creagic11/SNN_BTP/paper/hush_paperA.tex

% Paper A draft (A8.2), started 10 Nov 2026. IEEE two-column conference format (fits TCAS-II brief after cuts, or FCCM).
% Every number is traced to a file in results/ (see notes/paper_outline.md). \pend{...} marks items still to confirm.
% Revised 11 Nov 2026 after an external review (scope of the safety claim, full-width proof, resource accounting,
% heuristic comparison with charged reads, energy and real-time wording, architecture figure, reproducibility).
% Revised again 11 Nov 2026 after a second fresh-eyes review (epoch counts, drift metric, scope of the proof,
% real-time energy at a common speed, references, figures).
\documentclass[conference]{IEEEtran}
\usepackage{amsmath,amssymb,amsthm}
\usepackage{booktabs}
\usepackage{graphicx}
\usepackage{xcolor}
\usepackage{cite}
\usepackage{siunitx}
\usepackage{tikz}
\usepackage{url}
\usetikzlibrary{arrows.meta,positioning,fit,calc}
\newcommand{\pend}[1]{\textcolor{red}{[#1]}}
\newtheorem{theorem}{Theorem}
\newtheorem{corollary}{Corollary}

\begin{document}

\title{HUSH: Provably Safe Sub-Block Hibernation for\\Real-Time Event-Driven SNN Inference on FPGAs}
\author{\IEEEauthorblockN{Anubhav Jha and Rajat Subhra Chakraborty}
\IEEEauthorblockA{Indian Institute of Technology Kharagpur, India}}
\maketitle

\begin{abstract}
In a fully connected spiking layer, most of the time and energy goes into fetching the weights of every neuron for
every input spike, although few neurons fire. We present HUSH, an output-side skipping scheme that puts a sub-block
of eight neurons to sleep for a timestep only when a cheap integer envelope proves that none of them can reach the
threshold. At every timestep the gated layer therefore emits exactly the spikes that the ungated update from its
current state would emit; only the state of sleeping neurons evolves approximately. The envelope combines the exact
maximum membrane potential of the sub-block with a per-input proxy table and is computed while the previous timestep
is processed; its envelope and lane arithmetic is verified formally at the implementation's bit widths. Trained with the gate in the loop, a 578-256-10 integer network on N-MNIST
runs on a Xilinx Artix-7 XC7A100T at 100\,MHz entirely on chip, from raw sensor events to the class: at 95.74\,\%
accuracy it is 2.44$\times$ faster than the same hardware with the gate off (115\,\textmu s vs.\ 280\,\textmu s per
inference; 98.21\,\% accuracy) with 57\,\% less active energy per inference (18.4 vs.\ 42.5\,\textmu J,
estimated from gate-level switching activity), and at 96.54\,\% 1.75$\times$ faster with 44\,\% less; the gate
costs 79\,\% more LUTs and 19\,\% more block RAM. On the same chip, with BASE's
10-epoch weights, the open Spiker+ generator needs 818\,\textmu s and 255\,\textmu J (6.0$\times$ BASE). In cycle-accurate RTL replay of
four N-MNIST recordings at their recorded timing, every 3\,ms window is processed within 4.5\,\textmu s of its end,
and the design sustains up to 1.33--2$\times$ the event rate of the ungated design with the same 1,024-event input
buffer.
\end{abstract}

\section{Introduction}
Event-driven spiking neural networks (SNNs) are attractive for always-on sensing because their input is sparse
and their arithmetic is additive. On FPGAs, accelerators usually exploit \emph{input} sparsity: work is done only
for input spikes that occur. For a fully connected layer with $N$ neurons, each input spike still costs $N$ weight
reads from block RAM, although in a given timestep only a few percent of the neurons fire. Skipping the
\emph{output} side, i.e.\ neurons that will not fire, is the remaining large saving, but it is hard: whether a
neuron fires depends on the very weights one wants to skip. The output-side schemes published for SNNs are, to our
knowledge, heuristics (they predict that a neuron stays silent and can be wrong) and therefore change the network's
behaviour in ways that are hard to bound.

We make output-side skipping \emph{provably safe}. Our contributions:
\begin{enumerate}
\item \textbf{HUSH gate:} an integer envelope per sub-block of eight neurons that upper-bounds every member's next
membrane potential from the sub-block's exact current maximum and a per-input proxy table; a sub-block sleeps only
if the bound is below threshold (Theorem~1), so at every timestep the gated layer emits exactly the spikes of the
ungated update from its current state. We separate this per-timestep guarantee from end-to-end equivalence, which it
does not give, and measure the difference. The RTL envelope and lane arithmetic is proved, at its real bit widths
and for all values, to keep the bound, given that each neuron's drive is at most the proxy drive $D_c$ (true by
construction of the proxy table).
\item \textbf{Architecture:} an envelope unit overlapped with the processing of the previous timestep, per-sub-block
weight-column RAM enables, a whole network on chip (hidden layer, output layer overlapped one timestep behind, and an
integer class decision), and a stream front-end that accepts raw DVS events.
\item \textbf{Evaluation on one chip:} bit- and cycle-exact RTL against a golden model; gate-level activity-based
power; the same RTL with the gate off as baseline (BASE); Spiker+~\cite{spikerplus} on the same device with BASE's weights;
three training seeds per point; and real-time operation on N-MNIST event streams replayed at sensor timing.
\end{enumerate}

\section{Background and related work}\label{sec:bg}
\textbf{Integer LIF.} Each neuron keeps a 16-bit saturating potential $V$. Per timestep $t$,
$U = \mathrm{sat}(L(V) + \sum_{j\in A_t} w_{j})$ with leak $L(V)=V-(V\gg k)$, $k=4$, INT8 weights and $A_t$ the
active inputs; the sum is exact before the single saturation. It spikes, $s=[U\ge\theta]$ ($\theta=64$), and keeps
$V' = U-\theta s$ (soft reset).

\textbf{FPGA SNN accelerators.} Spiker~\cite{spiker}, its generator Spiker+~\cite{spikerplus} and
FireFly~\cite{firefly} are clock-driven: every neuron is updated every timestep. Table~\ref{tab:sota} lists the designs we found that report N-MNIST
results on an FPGA. They differ in network, device and power method; for two we found no latency.

\textbf{Output-side skipping.} Three recent designs skip work for neurons predicted not to fire:
Early~\cite{early} stops accumulation for neurons whose partial sum of the largest weights stays below a tuned
threshold; SITRA~\cite{sitra} scores each output of a spiking transformer with a weight-MSB dot product and skips the
weight fetches of outputs it predicts silent, overlapping detection with the previous token; PS4~\cite{ps4}
speculates whether each neuron fires within a time window and recomputes the window step by step when a speculation
fails. Early and SITRA accept mispredictions: Early reports a 0.54\,\% mean accuracy loss over its benchmarks and
SITRA 1--2\,\%; PS4 trades mispredictions for recomputation time instead. All three use tuned thresholds or
speculation and are evaluated with architecture simulators and ASIC synthesis (28 or 65\,nm), not on an FPGA. SPARSH~\cite{sparsh}
skips zero weights, zero spikes and refractory neurons; C-STEP~\cite{cstep} and the early-stop of~\cite{cheng2025}
end inference early in time. For ReLU CNNs, SnaPEA~\cite{snapea} has an exact mode: with non-negative inputs and
weights sorted by sign, a convolution stops once its partial sum turns negative. It still reads weights up to that
point, per neuron, and has no state across time. HUSH differs in that its prediction is a proven bound that is
evaluated before any weight of the sub-block is read: a sleeping sub-block cannot
contain a neuron that would fire at that timestep, the bound carries membrane state across timesteps, and its
granularity matches a block-RAM column, so a skip removes whole memory reads on an FPGA.

\section{The HUSH gate}
Neurons are grouped into sub-blocks $c$ of $b=8$ (eight INT8 weights fill one 64-bit block-RAM word; other sizes
were not explored). Two tables are derived offline from the weights: the proxy
$P_{jc}=\max_{i\in c} W_{ji}$ and the mean $Q_{jc}=\lfloor \mathrm{mean}_{i\in c} W_{ji}\rfloor$. The hardware keeps
$R_c=\max_{i\in c} V_i$ exactly after every timestep. Before the weights of timestep $t$ are fetched, the envelope
unit accumulates $D_c=\sum_{j\in A_t} P_{jc}$ and evaluates
\begin{equation}
E_c=\mathrm{sat}\big(L(R_c)+\max(0,D_c)\big),\qquad g_c=[E_c\ge\theta].
\end{equation}
\begin{theorem}[Safety]
If $g_c=0$, every neuron $i$ in sub-block $c$ has $U_i<\theta$ in the ungated update from the same state.
\end{theorem}
\begin{proof}
$L$ is monotone, so $L(V_i)\le L(R_c)$; $W_{ji}\le P_{jc}$ gives $\sum_{j\in A_t}W_{ji}\le D_c\le\max(0,D_c)$; and
$\mathrm{sat}$ is monotone. Hence $U_i\le E_c<\theta$.
\end{proof}
A sleeping sub-block skips its weight reads. Its neurons are updated with a shared mean-field drive
$q_c=\sum_{j\in A_t}Q_{jc}$, $U_i=\mathrm{sat}(L(V_i)+q_c)\le E_c<\theta$ (since $Q_{jc}\le P_{jc}$), so they cannot spike either, and $R_c$ stays exact.

\textbf{What is guaranteed and what is not.} Two properties must be kept apart (Fig.~\ref{fig:scope}).
(A)~\emph{Per-timestep safety}: from HUSH's own state $V^{\mathrm H}_{t-1}$, the gated update emits exactly the
spikes of the ungated update, since awake sub-blocks are computed exactly and sleeping ones contain no neuron that
would reach $\theta$. This holds at every timestep, by Theorem~1. (B)~\emph{Trajectory equivalence} with an ungated
run, $V^{\mathrm H}_t=V^{\mathrm B}_t$, is \emph{not} guaranteed: a sleeping neuron receives the mean-field drive
instead of its own, so its state, and later spikes, can differ. We measured both on 1,000 test samples per point:
the golden model's shadow update finds no spike that HUSH suppresses relative to (A). (B) is far from exact: run
without the gate, the same weights emit 553 instead of 304 hidden spikes per sample (gentle; 658 vs.\ 390 gentler,
388 vs.\ 201 aggressive), the spike trains first differ in window 4 (median), and the class agrees for 90--96\,\% of
samples. The gated network is not an approximation of an ungated one: removing the gate from the gentle weights
lowers accuracy (93.5 vs.\ 94.8\,\% on these samples). Accuracy is therefore the measure of (B), and the gate is
trained into the network for that reason.

\begin{figure}[t]\centering
\begin{tikzpicture}[font=\scriptsize, st/.style={draw,rounded corners=1pt,minimum width=11mm,minimum height=5mm,inner sep=1pt},
  ar/.style={-{Latex[length=1.4mm]}}]
\node[st] (h0) {$V^{\mathrm H}_{t-1}$};
\node[st,right=10mm of h0] (h1) {$V^{\mathrm H}_{t}$};
\node[st,right=10mm of h1] (h2) {$V^{\mathrm H}_{t+1}$};
\draw[ar] (h0) -- node[above]{gated} (h1);
\draw[ar] (h1) -- node[above]{gated} (h2);
\node[st,below=7mm of h0,fill=black!6] (u1) {$S^{\mathrm{ungated}}_{t}$};
\draw[ar,dashed] (h0) -- (u1);
\node[right=1mm of u1,align=left] {(A) spikes of the gated step $=$ spikes of the\\ungated step from the same state: \textbf{proved}};
\node[st,above=6mm of h0] (b0) {$V^{\mathrm B}_{t-1}$};
\node[st,left=6mm of $(h0)!0.5!(b0)$] (v0) {$V_0{=}0$};
\draw[ar,dotted] (v0) -- (h0);
\draw[ar,dotted] (v0) -- (b0);
\node[st,right=10mm of b0] (b1) {$V^{\mathrm B}_{t}$};
\node[st,right=10mm of b1] (b2) {$V^{\mathrm B}_{t+1}$};
\draw[ar] (b0) -- node[above]{ungated} (b1);
\draw[ar] (b1) -- node[above]{ungated} (b2);
\node[right=2mm of b2,align=left] {(B) $V^{\mathrm B}=V^{\mathrm H}$?\\\textbf{not guaranteed}};
\end{tikzpicture}
\caption{Scope of the guarantee. Both runs start from the same $V_0=0$. (A) holds at every timestep; (B) does not,
because sleeping neurons receive the mean-field drive. Measured on 1,000 samples: 0 spikes violate (A); the
trajectories differ from window 4 (median) and the ungated run emits 1.8--1.9$\times$ as many hidden spikes.}
\label{fig:scope}\end{figure} We train with the gate in the loop: the
forward pass uses the hard gate, and gradients flow through whichever update (exact or mean-field) it selected. Two
penalties are added to the cross-entropy: the envelope's mean excess over the
threshold, $\lambda_e\,\mathrm{mean}_{c,t}\max(0,E_c-\theta)/\theta$, and the expected positive proxy drive per
timestep, $\lambda_d\,\mathrm{mean}_c\sum_j r_j\max(0,P_{jc})/\theta$ with $r_j$ the firing rate of input $j$,
which shrinks the largest weight of each sub-block. The three points use $(\lambda_e,\lambda_d)=$ (0.25, 0.1)
gentler, (0.5, 0.25) gentle and (2, 1) aggressive; larger penalty weights put more sub-blocks to sleep at some cost in
accuracy.

\section{Architecture}\label{sec:arch}
\begin{figure*}[t]\centering
\begin{tikzpicture}[font=\scriptsize, bx/.style={draw,rounded corners=1.5pt,align=center,minimum height=8mm,inner sep=2pt},
  mem/.style={bx,fill=blue!6}, ctl/.style={bx,fill=orange!10}, hm/.style={bx,fill=orange!10,draw=orange!70!black}, ar/.style={-{Latex[length=1.5mm]}}]
\node[bx] (fe) {Stream front-end\\(pool 2$\times$2,\\de-dup, markers)};
\node[mem,right=6mm of fe] (ev) {Event mem.:\\ring 1,024 ev.\\+ window ranges};
\node[hm,above right=2mm and 6mm of ev] (pq) {P, Q tables\\(1 B each per\\sub-block, input)};
\node[ctl,right=6mm of pq] (etu) {Envelope unit\\$D_c=\sum P_{jc}$, $q_c=\sum Q_{jc}$\\$E_c$, $g_c$ (bank $t{+}1$)};
\node[mem,below right=2mm and 6mm of ev] (w) {4 weight-column\\RAMs, 64 b\\(8 INT8 each)};
\node[bx,right=6mm of w] (pe) {32-lane PE\\4-stage pipeline\\accumulate (18 b)};
\node[bx,right=6mm of pe] (fin) {Finalise (2 st.)\\sat, spike, $V'$\\asleep: $L(V){+}q_c$};
\node[mem,above=4mm of fin] (vr) {$V$ (16 b), $R_c$\\(exact max)};
\node[bx,right=6mm of fin] (fifo) {Spike FIFO\\+ drain};
\node[bx,right=6mm of fifo] (l2) {Output layer\\(dense, 32 lanes,\\1 step behind)};
\node[bx,above=4mm of l2] (cls) {Class: argmax\\counts, $\Sigma U$};
\draw[ar] (fe) -- (ev);
\draw[ar] (ev) |- (pq);
\draw[ar] (ev) |- (w);
\draw[ar] (pq) -- (etu);
\draw[ar] (etu.south) -- node[right,align=left]{$g_c$} (pe.north);
\draw[ar,orange!70!black] ($(etu.south)!0.5!(pe.north)$) -| node[pos=0.25,above]{column enables} (w.north);
\draw[ar,orange!70!black] ($(etu.south east)+(-0.15,0)$) -| node[pos=0.75,left]{$g_c$, $q_c$} ($(fin.north west)+(0.12,0)$);
\draw[ar] (w) -- (pe);
\draw[ar] (pe) -- (fin);
\draw[ar] ($(fin.north)+(0.15,0)$) -- node[right]{$V'$} ($(vr.south)+(0.15,0)$);
\draw[ar] ($(vr.south)+(-0.15,0)$) -- node[left]{$V$} ($(fin.north)+(-0.15,0)$);
\draw[ar] (vr.north) |- node[pos=0.25,right]{$R_c$} ($(etu.east)+(0,0.12)$);
\draw[ar] (fin) -- (fifo);
\draw[ar] (fifo) -- (l2);
\draw[ar] (l2) -- (cls);
\end{tikzpicture}
\caption{HUSH whole-network datapath. The envelope unit computes the gates of timestep $t{+}1$ from the proxy and mean
tables while the PE processes timestep $t$; a sub-block's weight column is read only when its gate is set, and a
sleeping sub-block is finalised with the mean-field drive $q_c$. Blue: memories; orange: added by HUSH (the
envelope unit, the $P$ and $Q$ tables, and the gate and $q_c$ paths).}\label{fig:arch}\end{figure*}

\textbf{Hidden layer.} 256 neurons form 8 blocks of 32 lanes (4 sub-blocks of 8). The weight memory is four 64-bit
column RAMs, one per sub-block; a column is read only if its sub-block is awake. Per timestep the sequencer combines
the envelope bank (gates), then visits each block: an awake block streams the timestep's events through a
4-stage pipeline (event read, index register, weight read, accumulate) and finalises its lanes in two stages; an
asleep block takes 3 cycles (state read, mean-field finalise, write-back). The envelope unit for timestep $t+1$
runs during the block loop of $t$ (double-buffered banks; Fig.~\ref{fig:sched}). The cycle cost of a timestep with $n>0$ events is
$1 + \sum_{\beta} c_{\beta} + 2$ over the 8 blocks $\beta$, with $c_{\beta} = 4 + (n+4)$ for an awake block and 3 for an asleep one, plus any wait for the
envelope bank. Time is therefore saved per 32-neuron block (all four sub-blocks asleep), while energy is also saved per
8-neuron sub-block, whose weight column is not read.

\begin{figure}[t]\centering
\begin{tikzpicture}[font=\scriptsize, x=0.93mm, y=1mm,
  bk/.style={draw,minimum height=4.2mm,inner sep=0pt,anchor=west,font=\tiny},
  aw/.style={bk,fill=blue!10}, sl/.style={bk,fill=black!12}, ev/.style={bk,fill=orange!18,draw=orange!70!black}]
\node[anchor=east] at (-1,12) {Envelope unit};
\node[anchor=east] at (-1,6) {Hidden layer};
\node[anchor=east] at (-1,0) {Output layer};
\node[ev,minimum width=19mm] at (3,12) {gates of $t{+}1$};
\node[ev,minimum width=15mm] at (38,12) {gates of $t{+}2$};
\node[bk,minimum width=2mm] at (0,6) {};
\node[aw,minimum width=10mm] at (2,6) {awake};
\node[sl,minimum width=2.2mm] at (12,6) {};
\node[sl,minimum width=2.2mm] at (14.2,6) {};
\node[aw,minimum width=10mm] at (16.4,6) {awake};
\node[sl,minimum width=2.2mm] at (26.4,6) {};
\node[sl,minimum width=2.2mm] at (28.6,6) {};
\node[sl,minimum width=2.2mm] at (30.8,6) {};
\node[bk,minimum width=2mm] at (33,6) {};
\node[bk,minimum width=2mm] at (35,6) {};
\node[sl,minimum width=2.2mm] at (37,6) {};
\node[aw,minimum width=10mm] at (39.2,6) {awake};
\node[sl,minimum width=2.2mm] at (49.2,6) {};
\node[sl,minimum width=2.2mm] at (51.4,6) {};
\node[bk,draw=none,minimum width=4mm] at (53.6,6) {\dots};
\node[bk,minimum width=14mm] at (2,0) {spikes of $t{-}1$};
\node[bk,minimum width=12mm] at (37,0) {spikes of $t$};
\draw[densely dashed] (0,-3.5) -- (0,15.5); \draw[densely dashed] (35,-3.5) -- (35,15.5);
\node at (17.5,16.5) {timestep $t$}; \node at (46,16.5) {timestep $t{+}1$};
\draw[-{Latex[length=1.4mm]},orange!70!black] (22,9.9) -- (22,8.6) -- (36,8.6);
\node[anchor=west] at (-14,-6) {\tiny blue: awake block, $8+n$ cycles ($n$ events)\quad grey: asleep block, 3 cycles\quad white: control};
\end{tikzpicture}
\caption{Schedule of one timestep (not to scale). The eight 32-neuron blocks are visited in turn; the envelope
unit prepares the gates of the next timestep meanwhile, and the output layer consumes the previous timestep's
spikes.}\label{fig:sched}\end{figure}

\textbf{Whole network.} Hidden-layer spikes enter a 32-entry FIFO; a drain converts each set bit into an event of the
output layer (32 lanes, 10 used, dense), which runs one timestep behind the hidden layer and overlapped with it.
The class is the integer argmax of spike counts, ties broken by the summed pre-reset potential, then by index.

\textbf{Stream front-end.} Raw DVS events $(x,y,p)$ are pooled $2\times2$ into the 578 inputs, de-duplicated per
window (the model's input is a 0/1 raster), and written into a ring of 1,024 events (one RAMB18); an end-of-window
marker closes the window, writes its range and lets the hidden layer start its envelope pass for that window.
Markers have reserved FIFO space, so overload can only drop events. In stream mode the whole network takes
8,736 LUTs / 48.5 BRAMs (BASE) and 14,606 / 62.5 (HUSH), both at 100\,MHz.

\section{Verification}
A golden integer model (Python) defines the behaviour. The RTL matches it bit for bit on 80 randomised layer
configurations (gate, mean-field, sizes, leak, threshold, load port) and, for the whole network, on 50 N-MNIST test
samples for each of four weight sets: every hidden and output block result and every class, with cycle counts equal
to an exact cycle model. Forty random whole networks (including a 4-entry spike FIFO that forces back-pressure) are also bit-exact. The
stream mode is bit-exact in every run without dropped events, at true sensor timing and up to 2,000$\times$ replay. The
safety arithmetic is verified formally with SymbiYosys (ABC PDR) on the RTL modules used in the design, in two
complementary checks. (1)~At the implementation's widths (16-bit $V$, 18-bit accumulators, $k=4$, $\theta=64$; both
the 578-input and the 256-input layer), one timestep of an 8-lane sub-block with every value free proves that, if
each $V_i\le R_c$ and each neuron's drive is at most $D_c$: a sleeping sub-block contains no neuron whose ungated $U$
reaches $\theta$; every $U_i\le E_c$, awake or asleep; no sum wraps around (each 18-bit result equals the same sum
computed 8 bits wider); and $R'=\max V'$ restores the hypothesis. With $V=R=0$ at reset this is an induction over
timesteps (72\,s). The last property only checks that a maximum bounds its inputs; the RTL's max tree for $R_c$ and
the second finalise stage are covered by the simulations below. The 256-input run adds only the no-wrap check at the
output layer's widths. (2)~A sequential model at reduced widths proves the same properties over unbounded time for
both sleep semantics. Mutants with an unsafe proxy (drive allowed above $D_c$) fail both checks immediately. The
assumption on the drive is discharged by construction: the proxy and mean tables are generated offline from the
weights and checked by the bit-exact simulations, which also cover memories and sequencing. Table~\ref{tab:widths}
lists the bounds.

\begin{table}[t]\centering\caption{Widths and the values that can occur (hidden layer, $M=578$).}\label{tab:widths}
\setlength{\tabcolsep}{3pt}\footnotesize
\begin{tabular}{lll}\toprule
Quantity & Width & Range that can occur\\\midrule
$W$, $P$, $Q$ & 8 b & $[-128,127]$\\
$V$, $R$ ($L(V)$) & 16 b & $[-32768,32767]$ ($|L(V)|\le 30720$)\\
$D_c$, $q_c$ ($\le 578$ inputs) & 18 b & $[-73984,73406]$\\
Lane sum $L(V)+\sum W$ & 18 b & $[-104704,104126]$ (18 b: $\pm131072$)\\
$U$, $E$ & 18 b & clipped to the 16-bit range\\
Class $\Sigma U$ per output & 32 b & $|\Sigma U|\le 3.28\,$M\\\bottomrule
\end{tabular}\end{table} Gate-level simulation of the routed
netlists reproduces the model's cycle count for every inference (+3 cycles of restart).

\section{Results}\label{sec:res}
\textbf{Setup.} XC7A100T-1CSG324C, Vivado 2024.1, 100\,MHz. Power is Vivado's estimate (\texttt{report\_power})
annotated with the gate-level switching activity (SAIF) of 20 back-to-back test inferences on the routed netlist
(99.9--100\,\% of nets matched, confidence High); it is not a board measurement. Energy per inference $=$ power
$\times$ latency while the chip is processing (\emph{active} energy; Section~\ref{sec:rt} discusses energy at sensor speed).
All HUSH and BASE builds use Vivado's default synthesis and implementation directives.
Accuracy on the full 10,000-sample N-MNIST test set ($T=100$ windows of 3\,ms) with the hardware's integer decision
rule; accuracy and latency over three training seeds; area, power and energy for the seed-0 networks on 20 samples.
BASE's power and energy were estimated with its own (22-epoch) weights; they equal those of the 10-epoch BASE
(152\,mW, 42.5\,\textmu J). Training (Table~\ref{tab:train}) uses the integer model of Section~\ref{sec:bg} in PyTorch and
keeps the final epoch (no model selection on the test set); the trained weights are then evaluated in the exported
integer model, which applies the 16-bit clip that the training model omits.

\begin{table}[t]\centering\caption{Training setup (all points, N-MNIST).}\label{tab:train}
\setlength{\tabcolsep}{3pt}\footnotesize
\begin{tabular}{@{}lp{0.74\columnwidth}@{}}\toprule
Input & N-MNIST~\cite{nmnist}, 34$\times$34$\times$2 events, 2$\times$2 pooling $\rightarrow$ 578; $T=100$ windows of 3\,ms; 0/1 raster\\
Network & 578-256-10 integer LIF, $k=4$, $\theta=64$, soft reset (16-bit clip only at evaluation)\\
Weights & INT8: round-and-clamp in the forward pass, straight-through gradient\\
Spike gradient & fast sigmoid~\cite{neftci}, $1/(s(1+|x|/s))^2$ with $s=\theta/4$\\
Readout loss & cross-entropy on $(\#\text{spikes}+0.01\,\overline{U}/\theta)\cdot 25/T$\\
Regulariser & $5\cdot\max(0,\bar r-0.05)$ on the hidden firing rate $\bar r$\\
Optimiser & Adam~\cite{adam}, one-cycle schedule~\cite{onecycle} (15\,\% warm-up), batch 128\\
BASE & 10 epochs, peak lr 0.05; then 12 epochs from it, lr 0.02 (no gate)\\
HUSH & from 10-epoch BASE, lr 0.02, gate in the loop, $\lambda_e,\lambda_d$ per point; 12 epochs (gentler, gentle), 6 epochs (aggressive)\\
Seeds & 0, 1, 2 (weight init and batch order)\\\bottomrule
\end{tabular}\end{table}

\begin{table}[t]\centering\caption{Accuracy and latency, whole network on chip (mean $\pm$ std, 3 seeds; latency over 500 test samples).}\label{tab:front}
\setlength{\tabcolsep}{2.5pt}\small
\begin{tabular}{lcccc}\toprule
Design & Acc.\ (\%) & Reads$^c$ & Lat.\ (\textmu s) & Speedup$^e$\\\midrule
BASE (gate off)$^b$ & 98.21$\pm$0.13 & 1.000 & 279.5 & 1.00$\times$\\
HUSH gentler & 96.54$\pm$0.07 & 0.204 & 159.8$\pm$8.1 & 1.75$\times$\\
HUSH gentle & 95.74$\pm$0.07 & 0.118 & 114.9$\pm$7.0 & 2.44$\times$\\
HUSH aggressive$^a$ & 92.32$\pm$0.68 & 0.070 & 82.9$\pm$7.8 & 3.39$\times$\\\bottomrule
\multicolumn{5}{p{0.95\columnwidth}}{\footnotesize $^a$ fine-tuned for 6 epochs; the other gated points for 12. $^b$ trained as long as the gentler and gentle nets (10 + 12 epochs); 10 epochs only: 97.66$\pm$0.07. $^c$ weight-column reads relative to BASE; adding HUSH's own reads of $P$ and $Q$ (2\,B per sub-block and input,
vs.\ 8\,B per column), its total weight-memory traffic is 0.32--0.45 of BASE's. $^e$ mean of the per-seed ratios.}
\end{tabular}\end{table}

\begin{table}[t]\centering\caption{Hardware on XC7A100T, 100\,MHz (whole network, 20 on-chip samples).}\label{tab:hw}
\setlength{\tabcolsep}{2.5pt}\small
\begin{tabular}{lccccccc}\toprule
Design & LUT & BRAM & WNS & Lat. & Power & Energy \\
 & & & (ns) & (\textmu s) & (mW) & (\textmu J)\\\midrule
BASE & 7,745 & 80 & +0.956 & 279.5 & 152 & 42.5\\
HUSH gentler & 13,885 & 95 & +0.450 & 151.2 & 157 & 23.7\\
HUSH gentle & 13,885 & 95 & +0.450 & 115.3 & 160 & 18.4\\
HUSH aggr. & 13,885 & 95 & +0.450 & 87.7 & 164 & 14.4\\
Spiker+~\cite{spikerplus} & 13,548$^a$ & 70.5 & +0.005$^a$ & 818.4 & 311 & 254.5\\\bottomrule
\multicolumn{7}{p{0.95\columnwidth}}{\footnotesize Latency and power over the 20 simulated inferences; static power 101--102\,mW.}\\
\multicolumn{7}{p{0.95\columnwidth}}{\footnotesize $^a$ high-effort implementation; power measured on the default-effort netlist (WNS $-$0.241\,ns).}
\end{tabular}\end{table}

\textbf{Accuracy--savings front.} Table~\ref{tab:front} and Fig.~\ref{fig:front}; speedups are relative to the
ungated network of the same seed. The gentler and gentle networks are fine-tuned for 12
epochs from the 10-epoch ungated network, the aggressive one for 6 (not re-run at 12); the same fine-tuning without the gate raises the ungated network from 97.66\,\% to
98.21\,\%, so we use that network as BASE. Against it the gate costs 1.7--5.9 points and reads 7--20\,\% of the
weight columns (32--45\,\% of BASE's weight-memory bytes once its own $P$ and $Q$ reads are counted). Training longer with the gate (12 instead of 6 epochs) improved every
axis of the gentle point (95.37\,\%, 1.98$\times$ $\rightarrow$ 95.74\,\%, 2.44$\times$). In a single-seed test, a wider hidden layer (384) raised the ungated accuracy to 98.0\,\% but not the gated one
(95.9\,\%, 6 epochs).

\begin{figure}[t]\centering\caption{Accuracy against latency,
whole network on chip. Faint markers: the three seeds; solid: their mean $\pm$ std. Labels give accuracy and
speedup over BASE.}\label{fig:front}\end{figure}

\textbf{Same chip.} Table~\ref{tab:hw} gives the power builds; Table~\ref{tab:res} reconciles them with the stream
builds. A power build stores 20 test recordings on chip (53k events, $\approx$32.5 BRAM tiles) so that power can be
simulated over 20 inferences without a host; a stream build instead has the sensor front-end and a 1,024-event
ring. HUSH adds the same $\approx$6k LUTs and 14--15 BRAM tiles in both (envelope unit, $P$ and $Q$ tables,
sub-block control): 79\,\% more LUTs and 19\,\% more BRAM than BASE in the power builds. The LUT$\times$latency
product therefore improves less than latency: by 3\,\% (gentler), 26\,\% (gentle) and 44\,\% (aggressive).

\begin{table}[t]\centering\caption{Resources of the four builds (BRAM in 36\,Kb tiles).}\label{tab:res}
\setlength{\tabcolsep}{2.2pt}\footnotesize
\begin{tabular}{lcccccc}\toprule
Build & \multicolumn{2}{c}{Hidden layer} & Output & Glue$^f$ & \multicolumn{2}{c}{Total}\\
 & LUT & BRAM & LUT/BRAM & LUT & LUT & BRAM\\\midrule
BASE, power & 3,874 & 74 & 3,117/6 & 754 & 7,745 & 80\\
HUSH, power & 9,922 & 89 & 3,150/6 & 813 & 13,885 & 95\\
BASE, stream & 4,482 & 41.5 & 3,142/7 & 1,112 & 8,736 & 48.5\\
HUSH, stream & 10,365 & 56.5 & 3,122/6 & 1,119 & 14,606 & 62.5\\\bottomrule
\multicolumn{7}{p{0.95\columnwidth}}{\footnotesize Power builds hold 20 recordings on chip (Table~\ref{tab:hw});
stream builds hold a 1,024-event ring and the sensor front-end (Section~\ref{sec:arch}). $^f$ spike FIFO, drain, classifier,
front-end and board harness (UART loader, LED fold); total minus the two layers. All four meet 100\,MHz (WNS +0.252 to +0.956\,ns).}
\end{tabular}\end{table} Spiker+ (clock-driven, ungated) runs BASE's 10-epoch INT8 weights (97.53\,\% on its neuron semantics, fixed point
with 6 fractional bits), scans all 578 inputs serially each timestep and needs 81.8k cycles per inference in our
harness (81.4k for the bare generated network). With default implementation settings it misses 100\,MHz by
0.24\,ns; with high-effort directives it meets 100\,MHz (+0.005\,ns, 13,548 LUTs). Its power was measured on the
default-effort netlist; the high-effort one is estimated 4\,\% higher, so the reported Spiker+ energy is a lower
bound. With the gate, HUSH spends 44--66\,\% less energy
per inference than BASE although its power is 3--8\,\% higher: the extra envelope logic costs less than the time it
saves; this is active energy per inference (Fig.~\ref{fig:energy}). Two thirds of BASE's active energy is static
power integrated over its latency, so most of the saving comes from finishing sooner; dynamic energy alone falls
by 41--62\,\%. Spiker+ draws 311\,mW, 140\,mW of it in block RAM, which it reads every cycle (ours: 12\,mW, read only for
awake sub-blocks), and needs 6.0$\times$ the energy of BASE and 13.8$\times$ that of HUSH gentle. Energies in
Table~\ref{tab:hw} use the latency of the same 20 inferences (e.g.\ gentler 151.2\,\textmu s vs.\ 159.8\,\textmu s over
500 samples); the speedups of Table~\ref{tab:front} use the 500-sample means.

\begin{figure}[t]\centering\caption{Active energy per
inference (Table~\ref{tab:hw}), split into static power $\times$ latency (light) and dynamic energy (dark).
Spiker+ (254.5\,\textmu J, 171.9 dynamic) is off this scale.}\label{fig:energy}\end{figure}

\textbf{Heuristic gates (exploratory).} To show what the proof buys, we keep the HUSH-trained gentle network and swap only
the predictor, charging each its own memory reads: HUSH 2\,B ($P$, $Q$) per sub-block and active input; a
state-free proxy inspired by SITRA (count of negative weights among the active inputs; not SITRA's MSB dot
product) 1\,B of sign bits; an Early-style predictor ($L(V)$ plus the 8 largest active weights) the 8 weight
columns it needs before deciding. Thresholds are bisected to HUSH's column reads or total traffic
(Table~\ref{tab:heur}, 1,000 samples, seed-0 network). Matched on traffic, the Early-style predictor loses 1.2
points and suppresses 409 spikes; its charge is a lower bound (the 8 neurons of a sub-block may need different
top-8 sets), so its true traffic is higher. The state-free one cannot be matched exactly (integer threshold): at
the nearest step it moves 14\,\% more bytes than HUSH and still loses 7.4 points. The networks were trained for
HUSH, not for the heuristics, so this measures the predictors, not the best network each could reach.

\begin{table}[t]\centering\caption{Swapping the predictor (gentle network, 1,000 samples).}\label{tab:heur}
\setlength{\tabcolsep}{2.5pt}\footnotesize
\begin{tabular}{llcccc}\toprule
Matched on & Predictor & Acc.\ (\%) & Reads & Traffic & Suppr.\ spikes\\\midrule
-- & \textbf{HUSH} & \textbf{94.8} & 0.105 & 0.355 & \textbf{0}\\
reads & Early-style & 92.4 & 0.103 & 0.350 & 485\\
reads & SITRA-inspired & 68.1 & 0.102 & 0.227 & 117,450\\
traffic & Early-style & 93.6 & 0.116 & 0.359 & 409\\
traffic & SITRA-inspired & 87.4 & 0.279 & 0.404$^g$ & 74,095\\\bottomrule
\multicolumn{6}{p{0.95\columnwidth}}{\footnotesize Reads and traffic relative to BASE. $^g$ integer threshold; the
next step gives 0.23.}
\end{tabular}\end{table}

\section{Real-time operation}\label{sec:rt}
N-MNIST recordings deliver on average 41.9 raw events per 3\,ms window (26.5 distinct pooled inputs; maximum 96).
Real-time feasibility is shown by cycle-accurate RTL replay of N-MNIST event streams at their recorded timing,
not by a sensor connected to the board. \textbf{At true sensor timing} (4 recordings per design, gentle network, bit-exact, no drops) a window is processed in
1.47\,\textmu s on average with HUSH (3.04\,\textmu s BASE), at most 4.50\,\textmu s (6.64\,\textmu s), i.e.\
$\le 0.22$\,\% of the window; the class is ready 0.89\,\textmu s (2.03\,\textmu s) after the last window; the input
ring never holds more than 127 events. HUSH halves the average window (1.47 vs.\ 3.04\,\textmu s, $-$52\,\%) but
shortens the busiest one less, because most blocks wake up in it (Fig.~\ref{fig:act}): over 500 test recordings,
windows with 1--9 active inputs run 2.2$\times$ faster, windows with 60 or more 1.59$\times$.
\begin{figure}[t]\centering\caption{Cycles per 3\,ms window
against the number of active inputs in it (cycle model, 500 test recordings, gentle network), with the speedup
of HUSH above each pair.}\label{fig:act}\end{figure}
\textbf{Energy in real-time operation.} The 44--66\,\% saving of Section~\ref{sec:res} is active energy per inference. At sensor
speed the chip idles more than 99.9\,\% of the time, so a 300\,ms recording costs $\approx$30.3\,mJ of static energy
(101\,mW) for either design, and HUSH saves only its dynamic share (6.7 vs.\ 14.3\,\textmu J per inference), i.e.\
$<0.03$\,\% of the always-on total. HUSH's gain appears when the chip is kept busy, e.g.\ serving recordings
faster than real time. At 750$\times$, the highest replay speed at which BASE drops nothing on the heaviest
recordings, a recording occupies 0.40\,ms; static power over that time plus the dynamic energy of one inference
gives 101\,mW$\times$0.40\,ms $+$ 14.3\,\textmu J $=$ 54.7\,\textmu J for BASE and 102\,mW$\times$0.40\,ms $+$
6.7\,\textmu J $=$ 47.5\,\textmu J for HUSH gentle ($-$13\,\%); HUSH can also run at 1,000$\times$ (37.3\,\textmu J).
\textbf{Faster than real time.} Replaying the 20 test recordings with the most events (1.7$\times$ the mean rate)
with the same 1,024-event buffer, at speeds in steps of 250$\times$, BASE drops events above 750$\times$ real time, HUSH gentle above 1,000$\times$ on
all 20 recordings (23.7\,M events/s, 1.33$\times$) and above 1,500$\times$ for the median recording (2.0$\times$);
HUSH gentler also holds 750$\times$ on all 20 and 1,000$\times$ on 18 (Fig.~\ref{fig:replay}).
\begin{figure}[t]\centering\caption{Replay faster than real
time: how many of the 20 heaviest test recordings are processed bit-exactly with no dropped event (RTL, same
1,024-event buffer).}\label{fig:replay}\end{figure}
\textbf{Early decisions.} Because the class can be read after any window, Fig.~\ref{fig:early} reports accuracy vs.
elapsed sensor time. Between 21\,ms and 156\,ms the gentler network is more accurate than BASE trained equally long
(e.g.\ 87.7\,\% vs.\ 79.5\,\% at 60\,ms and 92.6\,\% vs.\ 88.9\,\% at 99\,ms); BASE leads from 159\,ms on.
The gated networks do not spike earlier or more (fewer output spikes in the first 99\,ms: 39--41 vs.\ 52) but
their early leading class is wrong less often (8.5--8.8\,\% vs.\ 10.6\,\% of 1,000 samples at 99\,ms).
The gentle network leads from 21\,ms to 144\,ms. An application that decides between 21 and 144\,ms is
therefore both faster and more accurate with either gated network. (Spike statistics: first 1,000 test samples.)
\begin{figure}[t]\centering\caption{Accuracy when the class is read after the first windows of a recording (seed-0 networks, 10,000 test samples). BASE is trained as long as the gentler and gentle networks.}\label{fig:early}\end{figure}

\section{Comparison with the state of the art}
\begin{table}[t]\centering\caption{FPGA SNN accelerators on N-MNIST.}\label{tab:sota}
\setlength{\tabcolsep}{2pt}\footnotesize
\begin{tabular}{lccccc}\toprule
Design & FPGA & Acc.\ (\%) & LUT & Power & Latency\\\midrule
Cheng et al.~\cite{cheng2025} & ZCU104 & 98.11 & 81.3k & 0.81$^d$ & n/a\\
FeNN-DMA~\cite{fenndma} & KV260 & 98.46 & 55.0k & 0.53$^d$ & n/r\\
Surrogates~\cite{surr2026} & xcvu9p & 96.4 & n/r & 0.31 & 5.9\,ms\\
Wu et al.~\cite{wu2023} & ZCU102 & 95.76 & 39.7--165k & 0.33--0.37 & 50\,ms\\
\textbf{HUSH gentler} & XC7A100T & 96.54 & 14.6k & 0.16/0.056$^d$ & 0.16\,ms\\
\textbf{HUSH gentle} & XC7A100T & 95.74 & 14.6k & 0.16/0.058$^d$ & 0.11\,ms\\\bottomrule
\multicolumn{6}{p{0.95\columnwidth}}{\footnotesize Power in W; $^d$ dynamic only; n/r: not reported; n/a: not available to us. HUSH LUTs: stream build (Table~\ref{tab:res}).}
\end{tabular}\end{table}
HUSH runs 37--435$\times$ faster per inference than the designs that report latency and needs 77--950$\times$ less
active energy per inference (18.4--23.7\,\textmu J vs.\ $\approx$1.83 and $\approx$17.5\,mJ computed by us as their power
$\times$ latency), on a smaller device with
3.8--5.6$\times$ fewer LUTs than Cheng et al.\ and FeNN-DMA and 2.7--11.3$\times$ fewer than Wu et al.'s range. Accuracy
is comparable to those two designs (96.54 vs.\ 96.4 and 95.76\,\%) and 1.6--1.9 points below the two larger designs;
with the gate off, the same hardware reaches 98.21\,\% at 280\,\textmu s. These rows are not like for like.
\emph{Networks}: Cheng et al.\ use a structured-sparse event-driven SNN, Wu et al.\ an asynchronously triggered one, FeNN-DMA a 512-neuron recurrent
network, the Surrogates design a VGG9-style convolutional SNN; ours is 578-256-10. \emph{Devices}: all others use
UltraScale+ parts with 1.8--19$\times$ the LUT capacity of the XC7A100T. \emph{Latency}: ours is the compute time of one 300\,ms recording
whose events are already on chip; the others report their own per-sample processing time. \emph{Power}: ours and
Cheng et al.'s are Vivado estimates from simulated activity, FeNN-DMA's is a vectorless estimate with the processing
system removed; the Surrogates and Wu et al.\ figures are as reported, and their energies are computed by us. Only the same-chip comparison
(Tables~\ref{tab:front}--\ref{tab:res}) isolates HUSH's own effect.

\section{Limitations and conclusion}
The evaluation covers one dataset and one small fully connected network with a single gated layer and one
sub-block size. The speedup depends on stream sparsity: per window it falls from 2.2$\times$ with 1--9 active inputs to
1.6$\times$ with 60 or more, as more sub-blocks wake up, and it tends to 1$\times$ on dense streams. Serving many
streams on one chip is limited by state memory, where BASE would fit more streams than HUSH. The gate costs
accuracy (1.7--5.9 points) and area (79\,\% more LUTs);
its guarantee is per timestep, not for the whole trajectory; power is estimated from simulated activity, not measured
on a board; and real time is shown by RTL replay at sensor timing, not with a live sensor. HUSH shows that output-side skipping in SNN hardware can be both effective and provably safe; extending
the envelope to convolutional layers and denser event streams (DVS-Gesture) is future work.

\textbf{Code availability.} The RTL, golden model, formal harnesses (SymbiYosys~\cite{sby}), training and
analysis scripts and all result files will be released with the paper.

\bibliographystyle{IEEEtran}
\bibliography{refs}
\end{document}
