creagic11/SNN_BTP/docs/README.md

# Technical notes

| File | Content |
| --- | --- |
| `theorem1_prime.md` | Theorem 1′: safety of envelope gating for recurrent adaptive LIF neurons, with proof |
| `headroom_model.md` | Model of when hibernation pays: membrane headroom against the per-step worst-case drive |
| `design/recurrent_envelope_drain.md` | Design decision for the envelope update of recurrent layers |
| `literature/novelty_check.md` | Novelty assessment against output-side skipping schemes and baseline availability |
| `literature/nmnist_dvs_fpga.md` | Published FPGA SNN accelerators evaluated on N-MNIST and DVS-Gesture |

The safety theorem for the feed-forward layer used in the paper (Theorem 1) is stated and proved in
`paper/hush_paperA.tex`, Section III.
