creagic11/SNN_BTP/progress.md

# HUSH v2 — Progress Log

This file is the resume point. If a session ends, read "Current state", then resume at the task marked **IN PROGRESS** or, if none, the first **TODO** in the "Paper A track" table.

- Proposal: `docs/proposal_v2.md` (live copy: Claude Doc "HUSH v2 — Revised BTP Research Proposal")
- Study checklist for the defense: `study.md`
- Zotero collection: "HUSH – Literature" (user library 22138861, collection key FA5TR3KP)
- Compute available in the cloud workspace: 2 CPU cores, 7 GB RAM, no GPU

Status keys: DONE · IN PROGRESS · TODO · BLOCKED · PAUSED · DEFERRED

## Current state

- **Last updated:** 2026-10-27 (23:59 IST)
- **Active plan:** Paper A track (decided 27 Oct) — see the table below. Resume at the first TODO in "Paper A track".
- **Done today:** Vivado 2024.1 P&R of BASE / HUSH-drop / HUSH-MF, all meeting 100 MHz on the XC7A100T (`results/vivado_2024_1/`); comparison report v1 against state-of-the-art FPGA SNN accelerators (Claude Doc, link below).
- **Next:** A3 — SAIF (activity-based) power: prepare an xsim script for the laptop; the user runs one command.
- **Waiting on the user:** GPU access (unknown; gates Paper B); whether a Nexys A7-100T board + USB power meter is available (gates A7).
- **Comparison report v1:** "HUSH vs State of the Art — Comparison Report (v1)", https://claude.ai/artifact/PHRvGNYWhkn9HiMooEmfsR
- **Laptop build folder:** `C:\Users\Anubhav\hush_fpga` (granted to the session; Vivado 2024.1; old reports in `old_runs/`). The device shell is a Linux VM: it can read/write the folder but cannot launch Windows Vivado, so the user runs Vivado commands.
- **GitHub:** pushes to `creagic11/SNN_BTP` work (enabled 2026-10-24).

## Decisions log

| Date | Decision | Why |
| --- | --- | --- |
| 25 Oct | Tier-1 plan written (P1–P6, gates GA–GE) | user asked how to reach tier-1 (`docs/tier1_plan.md`) |
| 26 Oct | Recurrent envelope drain: duplicated dual-port P_rec BRAM + overlap with next block + awake-first scheduling (user chose option b) | tail 6.6% → 0.46% (`docs/design/recurrent_envelope_drain.md`) |
| 26 Oct | Pivot SHD path from recurrent adLIF to FF LIF + learned axonal delays (user approved) | recurrent adLIF gates poorly (reads 0.98; headroom 0.09θ) |
| 27 Oct | **Scope: option 1 now (Paper A, tier-2), option 2 later (Paper B, tier-1) when a GPU is available**; do GPU-independent work first | SHD gating costs accuracy (headroom model); no GPU yet |
| 27 Oct | Report results against published state-of-the-art works on every axis (accuracy, latency, energy, power, resources, safety), at current accuracy; use the report to justify a GPU and a Nexys A7-100T board | professor's instruction relayed by the user |
| 27 Oct | Three RTL timing fixes (pipelined R refresh, two-stage finalize, balanced two-stage max tree) | HUSH failed 100 MHz (WNS −12.9 ns); all variants now close |

## Paper A track (tier-2: guarantee + headroom theory + measured hardware; target TCAS-II / FCCM 2027)

**Current plan (3 Nov): `docs/plan_nov2026.md`** — every task has numbered steps with "done when" checks; this table holds the status.

Agreed with the user (28 Oct, 00:19): finish the missing Paper A tasks except the board measurement, in this order — (1) A3 SAIF power [started 28 Oct; ~½ day, user runs Vivado], (2) A4 Spiker+ on the same chip [1–2 days, user runs Vivado], (3) A5 three seeds per N-MNIST point [~1 day CPU], (4) A8 paper draft [2–3 days, user and professor review], (5) A6 raise gated N-MNIST accuracy [~1 day CPU, outcome uncertain]. A7 (board) waits for hardware. Report v2 after A3 for the supervisor meeting.

| ID | Task | Status | Output / note |
| --- | --- | --- | --- |
| A1 | Vivado P&R of BASE, HUSH-drop, HUSH-MF at 100 MHz | DONE | `results/vivado_2024_1/` |
| A2 | Comparison report v1 vs state of the art | DONE | Claude Doc (link above) |
| A3 | SAIF power (gate-level, 20 N-MNIST samples) | DONE 28 Oct (v5, results/power_saif_v5) | supersedes vectorless + v4 numbers |
| A4 | Spiker+ on the same device and topology (A4.1–A4.6 in `docs/plan_nov2026.md`) | A4.1–A4.4 DONE 3 Nov; A4.5 in laptop run L1 | user runs laptop run L1; the repo has no LICENSE file, but the VHDL it generates carries the Unlicense (public domain) |
| A5 | 3 seeds per N-MNIST point (A5.1–A5.3) | DONE 3 Nov | `results/seeds_nmnist.md` |
| A6 | Raise N-MNIST gated accuracy (A6.1–A6.3) | TARGET MET 3 Nov (96.61 % at reads 0.201, seed 0); seeds 1–2 + SAIF pending | target ≥ 96.5% at reads ≤ 0.25 |
| A9 | Real-time inference on a live sensor stream: full network on chip, stream mode, streaming testbench (A9.1–A9.6) | TODO (4–7 Nov) | professor's request, 3 Nov; user runs part of laptop run L1 |
| A10 | Published FPGA results on N-MNIST / DVS-Gesture (A10.1–A10.4) | A10.1–A10.3 DONE 3 Nov; A10.4 report v3 pending | `docs/literature/nmnist_dvs_fpga.md`; ≥ 3 N-MNIST rows |
| A7 | Board ΔP measurement, BASE vs HUSH | BLOCKED | needs Nexys A7-100T + meter |
| A8 | Paper A draft (A8.0–A8.4; venue: TCAS-II or FCCM 2027, to confirm) | TODO (8–12 Nov) | |

## Paper B track (tier-1, needs GPU)

| ID | Task | Status |
| --- | --- | --- |
| B1 | Conv layers in golden model, trainer and RTL; envelope per output channel × spatial tile; extend Theorem 1 | TODO (golden + proof can start on CPU) |
| B2 | DVS-Gesture with the gate in the loop at slow leaks (headroom model) | BLOCKED (GPU) |
| B3 | Multi-array engine with awake-block queue (former P4) | TODO (no GPU needed) |
| B4 | Full paper (ICCAD 2027 / TCAD) extending Paper A | TODO |

## Phase 0 — Setup, literature, feasibility (target gate G0: 8 Nov 2026)

| ID | Task | Status | Output |
| --- | --- | --- | --- |
| T0.1 | Repo scaffold, progress.md, study.md, proposal copy | DONE | this file, `study.md`, `docs/proposal_v2.md` |
| T0.2 | Novelty check: read Early (ICCD 2024), SPARSH (ICCAD 2025), C-STEP (DATE 2026); update literature table | DONE | `docs/literature/novelty_check.md` |
| T0.3 | Confirm Spiker+ source availability (external baseline) | DONE | note in `docs/literature/novelty_check.md` |
| T0.4 | Integer golden kernel: REF, GATED, ORACLE + property tests of Lemma 1 and Theorem 1 | DONE | `golden/hush.py`, `tests/test_hush.py` |
| T0.5 | Dataset access in the workspace (MNIST, N-MNIST, SHD) | DONE | `scripts/get_data.py` |
| T0.6 | Train ungated INT8 baseline (MNIST 784-400-10 first), export integer weights | DONE | `train/`, `results/baseline_*` |
| T0.7 | Measure ρ before clustering: ORACLE vs HUSH-32 vs HUSH-8/32 | DONE (MNIST) | `results/rho_unclustered.md` |
| T0.8 | Co-inactivity clustering; re-measure ρ; write G0 report | DONE (MNIST); G0 report after T0.9 | `results/rho_unclustered.md` |
| T0.9 | Regime study: ρ and envelope gap vs active inputs per timestep; SHD and N-MNIST at fine time bins; firing-rate regularisation | DONE | `results/regime_study.md` |
| T0.10 | G0 report and go / pivot decision | DONE — GO, narrowed scope | `results/G0_report.md` |

### Subtask log

- 2026-10-24 · T0.1 · Cloned repo (was empty except README). Created folders `docs/ golden/ tests/ train/ rtl/ scripts/ results/`. Wrote progress.md, study.md, proposal copy. Push test: refused (no GitHub App access).
- 2026-10-24 · T0.2 · Read full texts via IEEE Xplore (IIT KGP access) in the browser pane: Early, SPARSH, C-STEP, plus newly found close prior art PS4 (ICCD 2024), SITRA (ISLPED 2025), TCAS-I 2025 DVS accelerator, GustavSNN (HPCA 2026). Added 4 items to Zotero. Verdict: output-side skipping exists (SITRA, Early, PS4) but all heuristic, per neuron, ASIC simulation; HUSH's claim narrows to provable bound + state carried across steps + BRAM-matched blocks + FPGA silicon. Written to docs/literature/novelty_check.md.
- 2026-10-24 · T0.3 · Spiker+ is public: github.com/smilies-polito/Spiker, PyPI `spikerplus`; MNIST, SHD and Vivado tutorials. No LICENSE file: use as baseline only.
- 2026-10-24 · T0.4 · `golden/hush.py`: REF, GATED (signed-proxy envelope, per-sub-block gates, monotone clip to vbits), ORACLE, layer-major `run_network`, integer `predict`. `tests/test_hush.py`: 13 tests, all pass (Lemma 1 exhaustive over ±65536 for k=1..8; Theorem 1, Corollary 1, oracle⇒envelope dominance, register range, gate-on ≡ REF, Corollaries 2–3, saturation) using Hypothesis with 200–400 random layers each. Mutation check: an unsafe mean-proxy gives 6,340 suppressed spikes over 200 layers, so the tests do detect broken gates. Proof note: the clip must be the same monotone function on U and Ê; added to the proof.
- 2026-10-24 · T0.5 · Workspace network reaches PyPI, PyTorch, Hugging Face, zenkelab, S3. Installed torch 2.14.1+cpu, snntorch 1.0.0, tonic 1.7.0. `scripts/get_data.py` downloads to `~/data` (= /root/data, not in git): MNIST 60k/10k; SHD 8,156/2,264, 700 channels, 20 classes; N-MNIST 60k/10k, 34×34×2 (keep the zip files: tonic re-downloads if they are missing).
- 2026-10-24 · T0.6 · `golden/encode.py` (deterministic integer IF rate encoder), `train/qsnn.py` (integer-unit LIF: INT8 STE weights, floor-STE leak, soft reset, fast-sigmoid surrogate), `train/train_mnist.py`. Smoke test: 6k samples, 1 epoch, 76.5% in 5 s. Full run 15 epochs launched; log in `results/train_mnist_400.log`.
- 2026-10-24 · T0.6 · MNIST 784-400-10 INT8: 97.53% test (PyTorch); golden REF bit-exact on 2,000 images (0 mismatches), max |U| 3,415. Input activity 11.8% (~90 inputs/step), hidden rate 18.7%.
- 2026-10-24 · T0.7/T0.8 · `scripts/measure_rho.py`, `scripts/cluster.py` (balanced k-means by weight or co-activity), `scripts/envelope_gap.py`. Result: HUSH gates nothing on rate-coded MNIST (awake every step except t=0). ORACLE ρ_blk 0.80–0.95. Drive gap ≈ 8θ (5.8 units per active input × 90 inputs). G0 FAILS on this workload; see `results/rho_unclustered.md`. Next: regime study (T0.9).
- 2026-10-24 · T0.9 (in progress) · Design fix: with the eager leak sweep the exact V of asleep neurons is known, so R_c = exact max V every step (`LIFParams.resync=True`, default); the v1 carried bound accumulated drive error up to 2^k× while asleep. Tests: 14 pass (new: exact resync never looser than carried bound). `golden/datasets.py` (MNIST, SHD, N-MNIST rasters); `train/train_snn.py` generic trainer with firing-rate regulariser, envelope-drive loss (`--env_lam`), warm start (`--init`). `scripts/measure_rho.py` rewritten: multi-layer, datasets, cycle model with leak sweep, column-read fraction. SHD input stats: distinct active channels per step 88/62/31/16/8 at T = 50/100/250/500/1000. Trained MNIST proxies: mean P8 = 6.7 ≈ 1.4σ_W (σ_W = 4.8). Running: SHD 700-256-20, T=250, k=5, rate target 5% (`results/train_shd_T250.log`).
- 2026-10-24 · T0.9 · SHD baseline 70.8%. Vanilla HUSH-8/32: read frac 0.97, 1.01×; ORACLE costs 11 pts accuracy (drop semantics). Gate-in-the-loop training (`QLinearLIF.gate_benv`, exceedance + envelope-drive losses, `scripts/check_bitexact_gated.py` passes): HUSH-8/32 64.9% full test, read frac 0.26, 1.70× cycles. Sweep running: `scripts/sweep_shd.sh` (4 runs: λ variants, ungated at 1.3% rate, gate without losses). See `results/regime_study.md`.
- 2026-10-24 · T0.9 · Sweep done: reads 0.86/0.68/0.26 at 68.8/68.7/64.9%; gate alone 70.5% at 0.97; control ungated 2.2% rate 69.5% → loss is from gating. Mean-field hibernation (`LIFParams.asleep_drive='mean'`, Q=floor(mean W) ≤ P, test added, trainer bit-exact) does not help at inference only; training runs launched (`scripts/sweep_shd_mf.sh`).
- 2026-10-24 · T0.9 · Mean-field results: mf_e05_d025 70.8% at reads 0.64 (no loss vs baseline); mf_e2_d1 64.4% at reads 0.18, 2.05× cycles. Next: N-MNIST baseline + gated runs (hidden 256, T=100 over 300 ms), then G0 report.
- 2026-10-24 · T0.9/T0.10 · N-MNIST 578-256-10 T=100 k=4: baseline 97.59%; mean-field gentle 95.32% reads 0.155, 2.17× cycles; aggressive 92.72% reads 0.058, 3.86×; vanilla HUSH on baseline 0.98 reads. Gated bit-exact check passes. G0 report written: GO with narrowed scope (`results/G0_report.md`).
- 2026-10-24 · T1.5 · Heuristic gates at equal reads: N-MNIST HUSH 95.5%/0 FN, SITRA-style 66.0%/15,121 FN, Early-style 93.5%/36 FN; SHD HUSH 70.7%/0, SITRA 48.0%/7,576, Early 65.3%/2. Caveats (Early predictor read cost uncharged; nets co-trained with HUSH) recorded.
- 2026-10-24 · T2.1/T2.2 · Tools installed in workspace: iverilog 12, verilator 5.020, yosys 0.33, cocotb 2.1, z3, boolector, SymbiYosys (from source, /usr/local/bin/sby). RTL v1 `rtl/hush_layer.sv` (GATE/MF params; double-buffered ETU overlapped with block loop; 4 sub-block column enables; counters). Bit-exact vs golden: 40/40 random regression cases (GATE/MF/k/θ/rates/partial gating) and real nets — N-MNIST mf (3 samples) and BASE, SHD mf — all PASS including counters (word reads, column reads, awake sub-blocks). RTL cycles N-MNIST sample: HUSH 7.9k–14.3k vs BASE 26.5k.
- 2026-10-25 · T2.1 · Regression found a bug: event-pointer width EAW = clog2(NEV) truncated the end pointer when NEV is a power of two; fixed to clog2(NEV+1); 60/60 new random cases pass. Safety arithmetic factored into `rtl/hush_arith.sv` (hush_envelope, hush_lane), used by both hush_layer and the formal harness `formal/fv_hush.sv`. SMT engines failed (boolector unroll crash, z3 4.8.12 stalls); ABC PDR proves the mean-field variant unbounded (PASS, 1,128 s); mutation with an unsafe mean proxy fails BMC immediately (non-vacuous); drop variant also PASS. User's laptop (Windows, `~/.Xilinx` present) likely has Vivado for Phase 3.
- 2026-10-25 · T2.4 · Exact RTL cycle model (fitted ETU constants n+3 / 1, start +1, ETU0 +2; 0 mismatches on 30 fresh random cases and N-MNIST). Whole-network RTL latency at 100 MHz (300 test samples): N-MNIST baseline BASE 286 µs; mf gentle HUSH 140 µs (2.04× vs baseline net), column reads 0.167; mf aggressive 86.7 µs (3.3×), reads 0.066. SHD baseline 815 µs; mf gentle 745 µs, reads 0.64; aggressive 402 µs (2.0×), reads 0.19.
- 2026-10-25 · T2.5 · Yosys 0.33 cannot parse the SV; yowasp-yosys 0.70 can (changed `parameter string` to untyped). N-MNIST layer: BASE 6.6k LUT/6.2k FF/36 RAMB36+3 RAMB18; HUSH-drop 12.1k/8.5k/+15 RAMB18; HUSH-MF 16.1k/11.0k/+30 RAMB18; 1 DSP (address multiply).
- 2026-10-25 · T2.6 · AB = clog2(2^15 + 128M + 1) + 1 (18 bits for M=578); state array to LUTRAM via st_valid bits (reset loop removed); state and R also cleared on every start. Yosys: BASE 3.9k/1.9k, drop 8.2k/3.7k, MF 10.9k/5.4k LUT/FF. Regression 40/40 + N-MNIST pass.
- 2026-10-25 · T3.1 prep · Board top with autorun, Nexys A7-100T XDC, non-project Vivado TCL (synth, place, phys_opt, route, utilization, timing, vectorless power, bitstream). iverilog compile and Yosys synth of the top pass.

## Phase 1 — Gated training (gate G1: 29 Nov 2026)

| ID | Task | Status |
| --- | --- | --- |
| T1.1 | Gate-in-the-loop trainer (STE on g_c, exceedance + envelope-drive losses, mean-field option) | DONE |
| T1.2 | θ_h sweep, accuracy vs ρ Pareto per dataset | TODO |
| T1.3 | N-MNIST and SHD feed-forward baselines | DONE (SHD 70.8%, N-MNIST 97.59%) |
| T1.6 | 3 seeds per Pareto point (SHD, N-MNIST); gentler N-MNIST points | PAUSED 26 Oct (SHD-FF seeds dropped; N-MNIST seeds moved to A5) |
| T1.7 | Bin-size sweep (SHD T=500/1000, N-MNIST T=200) | TODO |
| T1.8 | Energy model: reads + cycles + envelope overhead → dynamic energy estimate | TODO |
| T1.4 | G1 report | TODO |
| T1.5 | Heuristic-gate comparison: SITRA-style and Early-style gates at equal skip rate, count false-negative spikes vs HUSH | DONE (`results/heuristic_gates.md`) |

## Phase 2 — RTL and verification (gate G2: 27 Dec 2026)

| ID | Task | Status |
| --- | --- | --- |
| T2.1 | RTL: ETU, combine, scheduler, PE array, max trees, leak sweep | DONE v1 (`rtl/hush_layer.sv`; asleep pass 2 cycles/block, not yet a parallel sweep engine) |
| T2.2 | Testbench against GATED golden model | DONE (Icarus: `rtl/sim/run_case.py`, `rtl/sim/regress.py`) |
| T2.3 | SymbiYosys proof of the invariant at small sizes | DONE — PDR PASS for mean-field and drop; mutation FAIL as expected (`formal/README.md`) |
| T2.5 | Yosys synth_xilinx resource estimate before Vivado | DONE (`results/synth_yosys.md`) |
| T2.6 | Area optimisation: 18-bit accumulators, LUTRAM state, optional multiplexed ETU | DONE (first two; MF 10.9k LUT / 5.4k FF) |
| T2.4 | Performance counters, cycle model match within 1% | DONE — exact (0 mismatches, 30 random + real nets), `rtl/sim/cycle_model.py`, `scripts/rtl_perf.py` |

## Phase 3 — Implementation and power (gate G3: 24 Jan 2027)

| ID | Task | Status |
| --- | --- | --- |
| T3.1 | Vivado synthesis and P&R at 100 MHz on XC7A100T | DONE — all variants meet 100 MHz (`results/vivado_2024_1/`) |
| T3.2 | SAIF power over ≥100 samples per dataset | TODO |
| T3.3 | Board ΔP measurement, BASE vs HUSH | TODO |

## Phase 4–5 — Baselines, sweeps, writing (draft: 21 Feb 2027)

| ID | Task | Status |
| --- | --- | --- |
| T4.1 | Spiker+ on same topologies, same device | TODO |
| T4.2 | Sweeps: activity, B_env, θ_h, T | TODO |
| T5.1 | TCAS-II brief draft | TODO |

## Tier-1 plan (25 Oct 2026) — superseded in scope on 27 Oct by the Paper A / Paper B tracks above

See `docs/tier1_plan.md` and the Claude Doc. Phases P1–P6 with gates GA–GE replace Phases 3–5 above once approved.

## Tier-1 Phase P1 — competitive workloads and near-lossless gating (gate GA: 22 Nov 2026)

GA criterion: SHD recurrent adLIF ≥ 90% ungated; HUSH ≤ 0.5 pt loss at ≥ 2× fewer reads; 3 seeds. **Outcome (27 Oct): not met** — best SHD 87.8% ungated (delays); gating costs accuracy on high-accuracy SHD nets (headroom model).

| ID | Task | Status | Output |
| --- | --- | --- | --- |
| P1.1 | Golden model for recurrent adLIF + headroom envelope; Theorem 1' + property tests | DONE | `golden/hush_rec.py`, `tests/test_hush_rec.py`, `docs/theorem1_prime.md` |
| P1.2 | Integer adLIF trainer (QRecAdLIF, QRSNN), bit-exact check, SHD baselines | DONE — 83.1% (val protocol) | `train/qsnn.py`, `scripts/check_bitexact_rec.py`, `scripts/sweep_rec*.sh` |
| P1.3 | Learned grouping | DONE — negative result (absorbed by co-training) | `scripts/regroup.py` |
| P1.4 | Gated co-training (recurrent, then delay nets) | DONE — negative: recurrent reads 0.98; delays k = 2 reads ≥ 0.94; k = 4 reads 0.77 at −6.7 pt | `docs/headroom_model.md` |
| P1.5 | Clamped low-rank hibernation (any asleep drive, clamped to D_c) | DONE (golden + proof + trainer lr1); co-trained comparison deferred | `golden/hush_rec.py` (`lr<r>`, `exact`), `scripts/hibernation_ceiling.py` |
| P1.6 | Distillation from the ungated teacher into the gated student | DEFERRED (scope change 27 Oct) | |
| P1.7 | 3 seeds of the chosen points | MOVED to A5 (N-MNIST) | |

### P1 subtask log

- 2026-10-26 · P1.1 · `golden/hush_rec.py`: recurrence as extra input rows z = [x_t; s_{t-1}], Wc = [Wff; Wrec]; integer adLIF w' = clip(L_kw(w) + (a·V') >> sa + b·s). Gate on the drive-free part B = L(V) − w: clip(max_c B) + z·P ≥ θ_h, forced awake if max B > vmax. 9 Hypothesis tests pass (reduces exactly to v1 golden; no suppressed spike incl. negative adaptation; gate-on ≡ REF; signed D never looser; mean-field asleep < θ; register ranges; saturation). Mutations (ignore −w, no saturation force, drop recurrent proxy rows) fail 5/2/6 of 9 tests.
- 2026-10-26 · P1.1 · Signed-D gate (allowed by the new proof) vs v1 max(0, D) on the 4 trained FF nets: identical reads and accuracy. No gain; recorded honestly.
- 2026-10-26 · P1.2 · `QRecAdLIF`/`QRSNN` integer-faithful (0 spike/U mismatches vs golden, ref/gated/mean). Gradient explosion (1e9–1e27) traced to a < 0: Lemma 2 (Jury criterion) — stable iff −a/2^sa < 2^−(k+kw). Our update is already symplectic Euler (Baronig et al., Nat. Commun. 2025, added to Zotero), so a ≥ 0 gives guaranteed stability. Constrained a ∈ [0, 32], rec init 0.1θ/√N. Non-spiking readout (`--readout u`, class = argmax ΣU, 24-bit accumulator; measured max |U| fits 15 bits).
- 2026-10-26 · P1.2 · 5-epoch probe (700-256r-20, T=250): 82.3% test (FF best was 70.8% after 25 epochs), hidden rate 15%. Golden check bit-exact (50 samples). Vanilla HUSH on it: reads 0.99 (not co-trained). Speed: ~95 s/epoch alone; an orphan run from the old sweep had slowed everything 10×: run one job at a time.
- 2026-10-26 · P1.3 · `scripts/regroup.py` (balanced start + best-pair swaps minimising J = Σ_c Σ_j r_j relu(P_jc)). Works on random (−8% J) and ungated N-MNIST (−5%), but 0 improvement on co-trained nets: co-training creates tied sub-block maxima (rows with tied positive max 11–12% → 36–54%), i.e., the weights adapt to the grouping. Post-hoc / learned grouping dropped from the plan.
- 2026-10-26 · P1.5 · New safety rule: asleep drive A_i may be any approximation if clamped to min(A_i, D_c) (D_c already computed by the envelope unit; one compare per neuron per step). Proof: U_sleep ≤ Bmax + D_c < θ_h. Golden `asleep_drive = lr<r>` (rounded mean + r−1 quantised SVD directions, 4-bit β per neuron, int8 tables) and `exact` (clamped exact drive). Property test added; all 25 tests pass. Fixed a test assumption: with signed D, θ_h = vmin no longer forces the gate on.
- 2026-10-26 · P1.5 · Post-hoc on the aggressive mf nets (300 samples), acc / reads: SHD ungated 54.0/1.00, drop 52.7/0.42, mean 59.3/0.18, lr1 64.0/0.23, lr2 60.0/0.30, lr3 57.7/0.33, exact 54.0/0.35; N-MNIST ungated 88.0, drop 88.0/0.17, mean 90.7/0.06, lr1 92.7/0.11, lr2 91.3/0.14, lr3 89.7/0.15, exact 88.0/0.17. Lesson: "exact" equals the ungated net, which is worse than the gated one because the co-trained net's function is the gated net. The asleep drive is a training-time design choice, not an approximation error; low-rank must be compared after co-training each variant. The floor-mean bias (towards sleep) is what buys the low read fraction.
- 2026-10-26 · P1.2 · 30-epoch baselines (700-256r-20, T=250, u readout, lr 0.02): plain best 82.4% (ep 6), final 78.1%, rate 18%; dropout 0.1 + rate 5% best 81.5%, final 79.1%, rate 9%. Not overfitting: training loss stuck ≥ 0.78 with a spike at epoch 8 (0.80 → 1.46).
- 2026-10-26 · P1.2 · Cause found (Lemma 3, `docs/theorem1_prime.md`): with surrogate scale θ/4 the reset-path factor 1 − θσ′ reaches −3, so near-threshold neurons amplify BPTT gradients (1e27–1e30 or NaN at init on 3/4 seeds once per-neuron leaks up to k = 7 are used). Scale θ/2 bounds it to [−1, 1] (3e−4–7e−4); detaching the reset also works. Default changed to θ/2. Added heterogeneous per-neuron leak shifts k ± 2, kw ± 2 (fixed; golden `RecLayer.kv/kwv`, bit-exact), dropout 0.15 (as in Baronig et al.), grad clip 2. Running: `shd_rec_het` (40 epochs, lr 0.01).
- 2026-10-26 · P1.2 · `shd_rec_het` (θ/2, het leaks, drop 0.15, clip 2, lr 0.01, 40 epochs): best 69.4% (ep 5), collapse at epoch 8 (loss 1.65 → 3.10), final 63.2%. Worse than homogeneous. Debug run with `--log_grad`: first spike at epoch 5 batch 98, dominated by the adaptation coupling a (‖∇a‖ 5.5 vs 0.07–0.39 others). Analysis: at a neuron on threshold the reset factor is −1; the spike-triggered adaptation path b·σ′ then gives the (V, w) loop det −λμ and trace μ − λ − bσ′, which is unstable once bσ′ > 1 − λμ ≈ 0.06 (b ≥ 2). Fix under test: `--detach_reset` (removes the reset and b·s paths, leaving Lemma 2's provably stable subthreshold dynamics). Running `shd_rec_het_det`.
- 2026-10-26 · P1.2 · `shd_rec_het_det` (detached reset): gradient → ∞ at epoch 3 (spike in w, wr, b ≈ 20 each), network frozen at chance (5.7%) for 40 epochs. Without the reset's damping the recurrent loop σ′·Wrec explodes. Conclusion: the surrogate peak is the common cause (θσ′ peak 4 at θ/4, 2 at θ/2; Bittar's SHD code uses a boxcar with θσ′ ≤ 0.5). Running `shd_rec_het_s1`: fast-sigmoid scale c = θ (peak θσ′ = 1, reset factor in [0, 1]).
- 2026-10-26 · P1.2 · `shd_rec_het_s1` (surrogate scale θ, het, drop, clip, lr 0.01): no collapse but plateau (train loss ≈ 1.45, best 72.1% by epoch 12); stopped. Too many simultaneous changes since the 82% run → controlled one-change ablation `scripts/ablate_rec.sh` (6 epochs each: base θ/4, θ/2, θ, het, dropout, lr 0.01) running.
- 2026-10-26 · P1.2 · Ablation round 1 (6 epochs, one change from the 82% recipe): base θ/4 82.1% (rate 16.8%); θ/2 59.8%; θ 79.4% peak → 64.9%; het leaks: network silent (4.5%); dropout 0.15 82.5% (rate 13.9%); lr 0.01 69.6%. My Lemma-3 θ/2 "fix" was wrong for accuracy: default reverted to θ/4, doc corrected. Recipe now: θ/4, dropout 0.15, lr 0.02, short schedule (accuracy peaks at epochs 5–6; long one-cycle runs degrade). Added SHD channel pooling (`--pool`, OR of adjacent channels). Round 2 running (`scripts/ablate_rec2.sh`): T=100, pool 5, T=100+pool 5, hidden 512.
- 2026-10-26 · P1.2 · Ablation round 2 (6 epochs, base = θ/4 + dropout): T=100 (k=4) 68.8%; T=250 pool 5 (140 ch) 74.8%; T=100 pool 5 71.6%; T=100 pool 5 hidden 512 59.4%. All worse than base 82.5%, losses 1.5–1.8 with epoch-to-epoch dips: the optimisation itself is unstable, not the input format. Round 3 running (`scripts/ablate_rec3.sh`): max-over-time readout (`--readout umax`, integer decision argmax_c max_t U, one running-max register per class), logit scale 0.0625 / 0.25, batch 128.
- 2026-10-26 · P1.2 · Ablation round 3 (6 epochs): max-over-time readout `umax` 81.1% with monotone curve, train loss 0.70 (vs 1.13), rate 10.8%; logit scale 0.0625 75.6%, 0.25 79.4%; batch 128 77.2%. umax is the first smooth, sparse configuration; remaining gap looks like generalisation (speaker shift), not optimisation. Running `shd_rec_umax` (20 epochs). Risk to GA: after 3 ablation rounds the CPU-trainable single-layer INT8 model sits at 81–83%; 90% may need augmentation, more epochs or a GPU.
- 2026-10-26 · P1.2 · **`shd_rec_umax` (20 epochs, θ/4, dropout 0.15, umax readout): best 87.0% (ep 13), final 86.4%, smooth, rate 14%.** Golden bit-exact on 200 test samples (0 mismatches; readout 15 bits; golden acc 88.0% on that subset). Train loss 0.17 → generalisation gap. Added SHD event augmentation (`--aug_shift/--aug_stretch/--aug_jitter`); running `shd_rec_umax_aug` (30 epochs, shift ±20 ch, stretch ±10%, jitter ±2).
- 2026-10-26 · P1.2 · `shd_rec_umax_aug` (no clip): 86.5% at epoch 19, then collapse at epoch 21 (loss 0.47 → 1.40, acc 49.6%), final 74.5%. A late collapse at low LR points to a rare exploding-gradient batch (Adam step blow-up). Fixes: gradient clip 1 and a proper 10% validation split with best-val checkpoint (`--val_frac`; `weights.npz` = best val, `weights_last.npz` = last; test accuracy reported at the best-val epoch, SHD* protocol of Baronig et al.). Running `shd_rec_umax_aug_c1`.
- 2026-10-26 · P2 design · User chose option (b): duplicated recurrent proxy table (P_rec, plus Q_rec for mean-field) in its own BRAM, so recurrent envelope accumulation never contends with the PE weight port. Sizing: P_rec = 256 rows × 32 sub-blocks × 8 b = 64 Kb → 4 RAMB36 at 72-bit SDP width (half depth used); Q_rec the same → 8 RAMB36 total (XC7A100T has 135). Measured on the 87% model (60 test samples): FF events/step mean 31 (p99 177); recurrent spikes/step mean 36 (p99 85, max 102); spikes per 32-neuron block per step mean 4.5 (p99 13, max 19); last block mean 4.7 (p99 13). Open point (asked to user): absorbing the BLK_FIN spike burst on a 1-row/cycle port and the exposed tail after the last block of each step.
- 2026-10-26 · P2 design · User proposed a Pipelined Accumulation Buffer (PAB): a combinational adder tree merges a block's simultaneous spikes into one 256-bit update, staged in LUTRAM and drained to the duplicated proxy BRAM in the background. Review points: (1) D_{t+1} is 32 sub-block sums × 18 b = 576-bit register state, not BRAM; P_rec is a read-only table, so there is no read-modify-write loop; register accumulation is pipelined at 1 row/cycle, and the tail is (spikes of the last block) + ~3 cycles, not 3 × spikes; (2) the binding limit is operand fetch: merging k rows in one cycle needs k simultaneous 256-bit P_rec row reads (each row already spans 4 RAMB36 ports); (3) gate(t+1) needs the complete D_{t+1}, so the drain cannot be hidden behind the use it feeds. Question on operand fetch sent to user.
- 2026-10-26 · P2 design · User proposed Early-Fetch Pipelining (stream a P_rec row as soon as a neuron crosses threshold during its block pass). Review: in our dataflow the 32 lanes process all neurons of a block in parallel and loop over input events, so U is final only after the last event of the step (BLK_FIN). Measured on the 87% model (20 test samples, hardware event order: FF ascending then recurrent): 75,523 neurons crossed θ mid-pass but did not spike, vs 187,103 true spikes (0.40 false crossings per true spike; 45% of Wc is negative). Speculative rows would therefore corrupt D_{t+1}; if a wrong row is negative it lowers D → unsafe (can gate off a sub-block that should be awake); rollback costs another row fetch. Question on spike finality sent to user.
- 2026-10-26 · P2 design · Decision recorded in `docs/design/recurrent_envelope_drain.md`: duplicated true-dual-port P_rec/Q_rec BRAM; each block's burst drains during the next block's PE pass; awake blocks scheduled first; spikes final only at BLK_FIN. Tail model (`scripts/rec_tail_model.py`, 40 SHD samples): naive 9.6k cycles/inference (6.6%) → overlap 1.3k (0.89%) → overlap + dual-port 0.66k (0.46%) of a 145k-cycle block loop.
- 2026-10-26 · P1.2 · `shd_rec_umax_aug_c1` (strong aug ±20 ch, clip 1, val 10%): stable (no collapse), best-val epoch 28 → val 85.7%, **test 79.2%** (max test 81.2%). Strong channel shift hurts (SHD channels are cochlear frequencies). Methodology correction: the earlier 87.0% was the best *test* epoch (not admissible); the honest figure for `shd_rec_umax` is its final epoch, 86.4%. Running `scripts/sweep_rec_val.sh`: plain recipe under the validation protocol, then mild augmentation (±4 ch, ±5% stretch, jitter 1).
- 2026-10-26 · P1.2 · Validation protocol (10% held out, best-val checkpoint, clip 1, no grad spikes): `shd_rec_v` val 92.3% / **test 83.1%** (last 82.9%), rate 13%; mild aug `shd_rec_v_augm` test 81.1%. Val–test gap (≈ 9 pts) is speaker shift; augmentation does not close it. Literature (added to Zotero; table in `docs/literature/novelty_check.md`): Spiker+ 73.0%, Matinizadeh 87.8%, SJTU FF + delays 93.4% on PYNQ-Z2 (40.5k LUT, 282 mW), event-graph 88.8–92.3%. Our 83% beats Spiker+ but trails delay-based FPGA work by ~10 pts. Decision on scope asked of the user (axonal delays). Meanwhile running gated co-training on `shd_rec_v` (`scripts/sweep_rec_gated.sh`).
- 2026-10-26 · P1 scope · User asked whether trained delay-SNN SHD models can be reused instead of training. Checked: SJTU FPGA paper (arXiv 2511.01158): no code, no weights, no availability statement (delays trained with DCLS, 8-bit post-training quantisation, 140 inputs, 10 ms bins, max delay 150 ms). DCLS-delays repo (github.com/thvnvtos/snn-delays, last commit Apr 2024): training code only, no checkpoints, no LICENSE file; recipe = 140 inputs (pool 5), 10 ms bins, 2×256 FF LIF, per-synapse learnable delays up to 25 steps, BatchNorm, dropout 0.4, ATan surrogate, 150 epochs, batch 256 (GPU-oriented). Even with weights, HUSH needs gate-in-the-loop integer co-training, so external weights could only warm-start. Per-synapse delays expand HUSH inputs to (input, delay) taps (event count × up to D); axonal (per-input) delays keep Theorem 1 unchanged.
- 2026-10-26 · P1.4 · **Gated co-training of the recurrent adLIF model fails to gate.** From `shd_rec_v` (83.1%), 12 epochs, best-val checkpoints: mf gentle test 81.6% at reads 0.984 (rate 5.7%); lr1 gentle 81.4% / 0.986; mf aggressive 82.3% / 0.993. Diagnosis (golden, 20 samples): mean D_ff/θ 2.61 and D_rec/θ 0.44 are similar to the FF net (D_ff/θ 2.25), but headroom differs: recurrent Bmax/θ = 0.91 (headroom 0.09θ) vs FF −8.67 (headroom 9.67θ). HUSH exploits co-trained hyperpolarisation; subthreshold adaptation (a > 0 pulls V back to rest from below) and recurrent excitation remove it. Strengthens the case for feed-forward + axonal delays (accuracy from delays, headroom kept). Possible ablation: adLIF with a = 0 (spike-triggered adaptation only).

### P1 pivot: feed-forward LIF + learned axonal delays (user approved 26 Oct, 23:46)

- 2026-10-27 · P1.D1 · `train/qsnn.py` AxonDelay (per-input delay d_j ∈ [0, dmax−1]; forward hard integer one-hot ⇒ trainer ≡ golden; gradient via Gaussian kernel of width σ annealed to 0 (DCLS-style), then triangular-kernel STE) and QDSNN (FF LIF, delay before every layer). `golden/hush_delay.py` (delay_events + run_delay_network); Theorem 1 unchanged (delayed stream is still a binary input stream). Bit-exact check `scripts/check_bitexact_delay.py` (ungated and gated: 0 mismatches). Test added (27 total pass).
- 2026-10-27 · P1.D1 · First run (σ0 = 12.5, no BN) stuck at chance after 3 epochs. Full-data 4-epoch probes (140-256-256-20, T = 100, pool 5): no delay 16.9%; delays σ0 = 2, k = 2 33.7%; k = 4 21.4%; hard from start 25.4%; + training-time BatchNorm 40.2%. Delays ≈ 2× the no-delay control. FF nets learn slowly; DCLS trains 150 epochs.
- 2026-10-27 · P1.D1 · BatchNorm deployment path: export BN (g, c); `scripts/fold_bn.py` folds to W′ = round(W g s), bias′ = round(c s), θ′ = round(θ s) with per-layer scale s = 127 / max|W g|. Per-neuron bias current added to golden (`RecLayer.bias`, part of the drive-free B, Theorem 1′ test with bias added) and trainer (loaded from `BI*`, per-layer θ from `TH*`). End-to-end smoke (train with BN → fold → check → gated fine-tune → check): 0 mismatches. Running `shd_delay_bn` (90 epochs, validation protocol).
- 2026-10-27 · P1.D2 · **`shd_delay_bn` (90 epochs, 140-256-256-20, T = 100, delays ≤ 25 steps, BN, dropout 0.4): best-val epoch 88 → val 93.8%, test 87.8%** (max test 88.5%, not used), smooth training, layer-1 rate 4.9%. BN folded (`results/shd_delay_fold`, scales 2.37/2.34, θ′ 152/150): **full-test 87.4% (fold costs 0.4 pt)**, bit-exact vs golden (300 samples, 0 mismatches). Un-co-trained gate: reads 0.997. Running `scripts/sweep_delay_gated.sh` (gated fine-tune from the folded net: mf gentle, mf aggressive, drop gentle; 15 epochs each). Fixed `--sig_frac 0` (now hard delays from the start).
- 2026-10-27 · P1.D3 · Gated fine-tune of the folded delay net (k = 2) barely gates: first attempt (lr 0.005) reads 0.997; with a separate bias lr (1.0) after 4 epochs: reads 0.967, rate 1.3%, test 85.3% (−2 pt). Diagnosis (golden, 20 samples): layer-1 events/step 23.5, D/θ′ 4.60, headroom 0.43θ′; layer-2 D/θ′ 2.88, headroom −0.17θ′. Headroom model written (`docs/headroom_model.md`): steady headroom ≈ θ + 2^k·|b|, so the leak shift multiplies hyperpolarisation; k = 2 gives 4× vs 32× for the old FF net (headroom 9.7θ). Tension: delay nets prefer fast leaks, HUSH prefers slow ones. Next: let the k = 2 gated sweep finish (Pareto point), then train a k = 4 delay baseline.
- 2026-10-27 · P1.D3 · k = 2 gated sweep (15 epochs each, best-val): mf gentle test 85.3% / reads 0.967; mf aggressive 84.5% / 0.985 (min reads 0.943 at 81.2%); drop gentle 85.7% / 0.988. Confirms the headroom model: at k = 2 HUSH saves ≤ 6% of reads. Running k = 4 delay baseline `shd_delay_bn_k4` (90 epochs).
- 2026-10-27 · P1.D3 · Container restart killed `shd_delay_bn_k4` at epoch 42/90 (no optimizer checkpoint). At epoch 42: k = 4 test 84.4% / val 90.9% vs k = 2 86.7% / 91.3% (≈ −2 pt). Folded the best-val checkpoint (epoch 39) → `results/shd_delay_fold_k4`: full test 84.3%. Headroom (golden, 20 samples): layer 1 1.23θ′ (k = 2: 0.43) vs D 5.33θ′; layer 2 −0.57θ′ vs D 2.08θ′ (6.7 events/step). Running gated sweep from it (`K=4 SUF=_k4 INIT=results/shd_delay_fold_k4/weights.npz scripts/sweep_delay_gated.sh`).
- 2026-10-27 · P1.D3 · k = 4 gated sweep (from folded k = 4, 84.3%): mf gentle final test 78.0% / reads 0.777 (best-val 79.6% / 0.932); mf aggressive 39.9% / 0.481; drop gentle 77.7% / 0.805. Gating now possible (k = 2 never below 0.94) but −5 pt already at epoch 1. Confound: the rate regulariser (target 5%) pushed hidden rate 8.7% → 1.6%. Controls running (`scripts/delay_k4_controls.sh`): rate reg without gate; gate without rate reg.
- 2026-10-27 · P1.D3 · Controls (k = 4, 15 epochs): rate reg without gate → 83.8% (rate 2.6%, −0.5 pt); gate without rate reg → 77.6% at reads 0.77 (−6.7 pt, rate 1.6%). The accuracy loss is caused by gating. Summary table added to `docs/headroom_model.md`. **GA status: not met** (best SHD: delays 87.4% ungated; no network yet gives ≤ 0.5 pt loss at ≥ 2× fewer reads on SHD). Scope decision requested from the user.
- 2026-10-27 · Scope · User chose option 1 (tier-2 paper A: guarantee + headroom theory + measured hardware), with option 2 (conv / DVS-Gesture, tier-1 paper B) added when a GPU is available; GPU-independent work first. Phase 3 prep: `fpga/run_all.tcl` builds BASE, HUSH-drop, HUSH-MF in one Vivado batch run; build.tcl paths normalised; N-MNIST hex images (2,669 events) in `fpga/hex`. Laptop is linked (Windows); the device shell is a Linux VM that cannot launch Windows Vivado, so the user runs one command. Waiting for: an empty folder `hush_fpga` in the user's home connected to the session, Vivado version, board.
- 2026-10-27 · T3.1 · User created and granted `C:\Users\Anubhav\hush_fpga`; Vivado 2024.1; board ownership unknown (not needed for P&R and vectorless power; matters later for T3.3). Copied RTL, XDC, hex images, build.tcl, run_all.tcl and README (12 files). User to run `vivado -mode batch -source run_all.tcl` from `hush_fpga/fpga`.
- 2026-10-27 · T3.1 · Vivado 2024.1 results: BASE 1,374 LUT / 502 FF / 20 RAMB36 + 2 RAMB18 / 0 DSP, WNS +0.026 ns at 100 MHz, vectorless 123 mW (25 mW dynamic). HUSH-drop (old RTL): 8,994 LUT / 3,145 FF / 50 RAMB36 + 3 RAMB18, **WNS −12.94 ns** (critical path: state read → lane update → 8-input max tree → R, 33 levels), 219 mW. Fix: R refresh pipelined one cycle after FIN (R first read ≥ 2 cycles later at COMBINE) — bit-exact, cycle count unchanged (regression 40/40; N-MNIST mf and drop 800/800). `fpga/run_hush.tcl` rebuilds HUSH-drop and HUSH-MF; waiting for the user to run it. BASE on the ungated N-MNIST net: 286.1 µs/inference (300 samples) → 35 µJ at 123 mW. Comparison report (Claude Doc) "HUSH vs State of the Art — Comparison Report (v1)": methodology, safety, accuracy, GPU/board and sources sections written; hardware, SOTA table and summary pending.
- 2026-10-27 · T3.1 · Rebuild with fix 1 used a stale RTL copy on the laptop (transfer delivered an old version; now verified by md5). Timing fix 2: two-stage finalize (register saturated U + awake bits; FIN2 applies spike/reset), +1 cycle per block; cycle model updated (awake 4 + (n+3), asleep 3); regression 40/40, N-MNIST mf/drop/base 800/800 bit-exact. Old Vivado reports moved to `hush_fpga/old_runs/`; full rerun (`run_all.tcl`) requested. New latencies (500 samples): BASE (ungated net, 97.59%) 294.0 µs; HUSH-MF gentle (95.32%) 149.3 µs (1.97×, col reads 0.168); aggressive (92.72%) 95.2 µs (3.09×, 0.067). Report: SOTA tables (N-MNIST, MNIST, SHD) filled; our rows pending the rerun.
- 2026-10-27 · T3.1 · Run 2 (two-stage finalize): BASE 1,314 LUT / 722 FF / 20 RAMB36 + 2 RAMB18 / 0 DSP, **WNS +2.103 ns at 100 MHz**, 113 mW (15 mW dynamic). HUSH-drop 8,998 LUT / 4,223 FF / 50 + 3, WNS −4.329 ns, 169 mW; HUSH-MF 11,089 LUT / 6,049 FF / 54 + 3, WNS −3.976 ns, 183 mW. Only setup violation: fin_word → 8-input max (serial chain) → R. Fix 3: balanced two-stage max tree (8→2 registered, 2→1 into R; R read ≥ 3 cycles later) — bit-exact, cycles unchanged; md5-verified on laptop; HUSH-only rebuild (`run_hush.tcl`) requested; v2 reports in `hush_fpga/old_runs/v2`.
- 2026-10-27 · T3.1 · **DONE — all three variants close timing at 100 MHz** (fix 3: balanced two-stage max tree). BASE 1,314 LUT, WNS +2.103 ns, 113 mW; HUSH-drop 8,797 LUT, +0.276 ns, 167 mW; HUSH-MF 10,960 LUT / 6,177 FF / 54 RAMB36 + 3 RAMB18 / 0 DSP, +0.451 ns, 190 mW (vectorless). Per inference: BASE 294.0 µs / 33.2 µJ; HUSH-MF gentle 149.3 µs / 28.4 µJ (1.97×, −15%); aggressive 95.2 µs / 18.1 µJ (3.09×, −46%). Reports archived in `results/vivado_2024_1/`. Comparison report v1 complete (Claude Doc "HUSH vs State of the Art — Comparison Report (v1)", https://claude.ai/artifact/PHRvGNYWhkn9HiMooEmfsR). Next: T3.2 SAIF power (xsim on the laptop) for v2.
- 2026-10-28 · Docs · Added an "Update, 27 Oct 2026" section at the top of the Claude Doc "HUSH — Plan to Reach Tier-1" (P1 outcome table, new Paper A/B scope, done-since, revised gates, next steps, link to the comparison report). Repo docs synced the same night (README, progress, study, tier1_plan, fpga/formal READMEs, literature table).
- 2026-10-28 · A3 · Found and fixed an autorun bug in `fpga/top_hush.sv` (start fired only on a rising edge of done, but done stays high in IDLE → one inference, then idle; now start is held while done is high). Verified: back-to-back inferences of 12,923 cycles each (= cycle model). SAIF flow: `scripts/make_saif_hex.py` (100 N-MNIST test samples ≤ 4,096 events; weight sets base = ungated net, mf_gentle, mf_aggr; expected cycles per sample: mean 27,333 / 14,002 / 8,676 for the hidden layer), `fpga/tb_saif.sv` (loads weights once and each sample while the layer is in DONE; iverilog check: every inference = model + 1 cycle), `fpga/run_saif.tcl` (rebuild BASE + HUSH-MF with the fixed top → xvlog/xelab/xsim with SAIF over 100 samples per case → read_saif on the routed checkpoint → report_power). Bundle delivered to the laptop, 213 files md5-verified; RTL md5 10004656… matches. Waiting for the user to run `vivado -mode batch -source run_saif.tcl`.
- 2026-10-28 · A3 · SAIF attempt 1 ran (100 samples per case, three ~143 MB SAIF files, cycles = model + 1) but is **NOT VALID**: read_saif matched only 67 of 3,216 design nets (BASE, 2.1%) and 757 of 27,514 (HUSH-MF, 2.8%); RTL signal names do not survive synthesis/flattening, so > 97% of nets fell back to default (vectorless) activity. Symptoms: implausible ordering (HUSH-MF aggressive 221 mW > gentle 210 mW > vectorless 190 mW; BASE 117 mW), Power 33-332 warning (a matched high-fanout net looks like a reset held asserted → mis-annotation), confidence "Medium" with < 25% internal nodes specified. Power 33-330 (clock-net activity ignored) is benign. Numbers archived as invalid; not reported anywhere. Proper fix proposed to the user: gate-level (post-implementation functional) simulation so SAIF names match the routed netlist 100%, which needs the samples stored on-chip (multi-sample event ROM + autorun over samples), one build per weight set.
- 2026-10-28 · A3 · User declined computer use (so Vivado runs stay user-started); asked for everything sequential and unattended. Proper gate-level SAIF flow built: on-chip store of 20 N-MNIST samples (`NSMP` parameter, `smp` port, top steps one sample per inference; 53,094 events in a 65,536-entry event store), found and fixed a latent width bug (17-bit event pointers sliced from 16-bit ts entries → X; now zero-extended), `fpga/run_power.tcl` = per case build → write_verilog -mode funcsim → xsim of the netlist with SAIF over 20 samples → read_saif on the routed checkpoint → report_power (cases: base / mf_gentle / mf_aggr, each with its own weights). Verified here: regression 40/40; 20-sample builds bit-exact vs golden for all three weight sets (16,000/16,000 block write-backs each). Bundle delivered (22 files md5-verified); invalid attempt-1 results moved to `hush_fpga/old_runs/out_saif_INVALID_rtl_names`. Note: power builds hold a larger event store than the timing builds (both BASE and HUSH alike); report it as such.
- 2026-10-28 (05:00 IST check-in) · A3 · Gate-level run 1 (`run_power.tcl`, started 02:46): all three builds OK (base 02:55, mf_gentle 03:14, mf_aggr 03:21; netlists written, snapshots compiled), but xsim crashed at load in every case (EXCEPTION_ACCESS_VIOLATION, no stack; journal empty; session header showed 4.4 GB available virtual memory vs 5.9 GB in the earlier working RTL run). Prepared `fpga/run_power2.bat` (standalone xsim outside Vivado reusing the snapshots; fallback rebuild with -debug wave; diagnostic plain run) + `fpga/annotate_power.tcl` (fresh Vivado: read_saif + report_power for cases with a complete SAIF). run_power2.bat delivered md5-verified; the laptop then went offline before the updated annotate_power.tcl (read_saif fallback without -out_file) could be copied — the laptop holds the earlier version (md5 0991…, also functional if -out_file is accepted). Next: when the laptop is back, copy `_unused/annotate_power_v2.tcl` (md5 4daf…) over `fpga/annotate_power.tcl`, then the user runs `run_power2.bat`.
- 2026-10-28 (10:50 IST) · A3 · run_power2.bat finished: all three gate-level simulations completed (20/20 inferences each; SAIF 1.1 / 7.3 / 7.1 MB). Annotation: **base OK** (69% of nets matched, 2,279/3,317, confidence High, 167 mW total). **mf_gentle and mf_aggr FAILED**: `read_saif` hit "syntax error, unexpected WORD" on the two 16-bit wires that Vivado's write_verilog named `\(null)[0].(null)[0].b2` / `.b21_out` (unnamed generate/loop scopes in the MF max tree of hush_layer.sv); xsim logged them verbatim and Vivado's SAIF parser cannot read that name, so parsing stopped there (105/43,473 nets). Fix without re-simulation: `act_clean.saif` = act.saif minus those 32 bit-lines (parenthesis balance checked), `fpga/annotate_power2.tcl` + `fpga/annotate2.bat` re-annotate all three cases and log the matched-net count to out_pwr/summary3.txt. Delivered, md5-verified (05129c75…, 56733931…). Permanent fix for later builds: name the generate scopes in hush_layer.sv. Waiting for the user to run annotate2.bat.
- 2026-10-28 (11:20 IST) · A3 · annotate2 ran clean (no parse errors): base 167 mW (69% nets matched), mf_gentle 253 mW (62%), mf_aggr 266 mW (62%), all confidence High; simulated cycles = model (+4/+8) for all three, SAIF durations = 20 × mean latency. Audit found two remaining issues: (1) **name-escaping mismatch** — every unmatched design net (1,038 in base) is an escaped identifier: xsim writes `\\acc\[0\]\[3\]_i_3_n_0\ ` while read_saif expects `acc\[0\]\[3\]_i_3_n_0`; these are the LIF lane adders, accumulators and spike outputs, so they fell back to vectorless activity. Fix: `scripts/fix_saif_names.py` → act_fixed.saif (base 3,510 names rewritten; mf 34,881 / 34,197; parenthesis balance 0), `fpga/annotate_power3.tcl` + `annotate3.bat` (reports power_saif_fixed.rpt, summary4.txt), delivered md5-verified (1e2dc749…, eb8d5bb9…). (2) **harness bias against HUSH** — in the HUSH power builds synthesis put the ETU's two reads of the 20-sample timestamp table (2,048×16) into LUT ROMs (+~10.2k LUTs, +4 DSP for the sample-base multiply; 21,222 LUT vs 10,960 in the timing build). BASE has no ETU, so it does not pay this. It inflates HUSH power; not part of the real design. Interim (annotate2) energy per hidden-layer inference at 100 MHz: base 45.3 µJ, mf_gentle 36.1 µJ, mf_aggr 22.5 µJ — to be replaced after annotate3.
- 2026-10-28 (11:30 IST) · A3 · annotate3 (escaped-name fix) clean: **100% of nets matched** in all cases, confidence High, timing met in all power builds. Results archived in `results/power_saif/` (README has the table and caveats). Energy per hidden-layer inference: base 45.3 µJ total / 18.5 µJ dynamic; mf_gentle 40.4 / 26.0; mf_aggr 25.2 / 16.6 → total-energy gain 1.12× / 1.80×, dynamic 0.71× / 1.11×. Honest reading: HUSH's gain is latency × static power; its dynamic power (BRAM 79–95 mW vs 56 mW, logic) is higher, partly from the harness ROM bias (+10.2k LUT). Next (A3b, proposed): remove the harness bias (timestamp table in BRAM for the ETU), rebuild + re-simulate the HUSH cases; investigate BRAM enable gating (largest dynamic term).
- 2026-10-28 (11:40 IST) · A3b · Reviewer-level audit of the power builds found four hardware-honesty issues beyond the harness ROM: (a) all tables were ROMs, so synthesis trimmed the INT8 weights to the 6 bits the trained values use (`pe_w_reg 8192x192` in the synth log) — area/BRAM understated vs any reprogrammable accelerator; (b) the RTL read the whole 256-bit weight word with one enable, so the per-sub-block column gating counted by `cnt_col_reads` (and claimed in the header) did not exist in hardware; (c) the ETU's ts reads became LUT ROMs (+10.2k LUT, HUSH only); (d) unnamed loop scopes produced `(null)` netlist names. **hush_layer v5**: every table is a writable RAM with a host load port (`ld_*`, driven by a new UART loader `fpga/uart_loader.sv` on the Nexys A7 USB-UART pin C4); weights in four 64-bit column RAMs read only when that sub-block is awake; ts stored as {ts[t+1],ts[t]} pairs in true-dual-port BRAM (ETU +1 cycle: n+4; cycle model updated; mean cycles gentle 14,265 / aggr 8,449, +0.01/+0.1%); `ram_decomp = "power"` on the deep event and weight RAMs (both BASE and HUSH); named generate scopes. Verified here: regression 80/80 incl. cycle-exact (now part of PASS) and 20 runs that fill every memory through the load port; UART loader unit test PASS; 20-sample power images bit-exact for all three weight sets (16,000/16,000 each). Test-harness bug found and fixed: iverilog ignores a bad `-P` value with exit code 0 (now an error). Flow: `fpga/run_v5.bat` = prep_v5.tcl (3 timing + 3 power builds, netlists, snapshots) → standalone xsim → annotate_v5.tcl (Tcl SAIF-name fix, identical output to the validated Python fix; energy.csv). Mock-tested the Tcl logic with tclsh. Delivered: 52 files md5-verified on the laptop.
- 2026-10-28 (12:25 IST) · A3b · run_v5 (out_v5) timing builds: base WNS +1.230 ns, hush_drop +0.590, hush_mf +0.219 (met); weights now full 64-bit columns (10 RAMB36 each, 5 deep × {36,28}). **Critical harness bug found in the base report**: only weight columns 0 and 3 exist — top_hush's LEDs observed lanes 0-5 and 26-31 only, so synthesis deleted lanes 6-25 (sub-blocks 1-2) and their weight RAMs. This affected EVERY earlier build (v4 base util_hier also lists only g_lane 0,1,26-29): BASE area (1,314 LUT) and BASE power were understated; HUSH less so (lanes stay coupled through R → gates). All previous BASE-vs-HUSH area/power numbers (results/vivado_2024_1, results/power_saif) are biased in BASE's favour and must not be used. Fix: top_hush XOR-folds all 32 spikes + 512 state bits into the LEDs (`fold6`). Re-verified 20-sample bit-exact (3 × 16,000/16,000). Flow redirected to out_v5b (no reuse of out_v5). User asked to stop run_v5 and restart.
- 2026-10-28 (12:55 IST) · A3b · out_v5b: observability fix confirmed (base now 32 lanes, 3,817 LUT, 43 BRAM in the timing build; 4 weight columns). Timing builds met (base +0.509, hush_drop +0.436, hush_mf +0.265 ns), but the 20-sample power builds FAILED (base −1.352, gentle/aggr −2.260 ns; 364/1,124 failing endpoints). Every failing path: ev BRAM (64K store, decomposed) → b*M + j → weight-RAM enable/WE decode (11.4 ns); the same path is the worst one in the timing build. **Timing fix 4**: register the event index (pe_jr, maps onto the BRAM output register) before forming the weight address; +1 cycle per awake block with events (PE_STAGES = 4; cycle model updated). New mean cycles: base 27,927 (+2.9%), gentle 14,566 (+2.1%), aggr 8,590 (+1.7%). Verified: regression 80/80 cycle-exact, power images 3 × 16,000/16,000 bit-exact. Flow redirected to out_v5c; delivered md5-verified. out_v5b power results must not be used.
- 2026-10-28 (17:25 IST) · **A3 DONE (v5, run out_v5c)**: all six builds meet timing (timing builds BASE +1.441 / HUSH-drop +0.198 / HUSH-MF +0.496 ns; power builds +0.270 / +0.491 / +0.491); nets matched 100%, confidence High; netlist cycles = model + 3..8. Energy per hidden-layer inference: BASE 40.49 µJ (12.57 dyn), HUSH-MF gentle 22.11 (7.17), aggressive 13.74 (4.90) → **1.83× / 2.95× total energy, 1.75× / 2.57× dynamic energy, 1.91× / 3.19× latency** at +4% / +8% power. Area: BASE 3,821 LUT / 43 BRAM vs HUSH-MF 9,800 LUT / 58 BRAM. Archived in `results/power_saif_v5/` (README + energy.csv); old results/vivado_2024_1 and results/power_saif superseded. Full reports archived in results/power_saif_v5/reports/ (copied 28 Oct 18:40 after a transient laptop-transfer failure; md5 verified). Next: comparison report v2 with these numbers, then A4 (Spiker+).
- 2026-10-28 (18:00 IST) · Report · Comparison report updated to **v2** (Claude Doc, same link): summary, measured-results tables, power method, new "Corrections since v1" section, SOTA rows, methodology bullet. Whole-network latency recomputed with the v5 cycle model (500 samples): BASE 302.9 µs, gentle 153.0 (1.98×), aggressive 97.2 (3.12×); energy = SAIF power × latency: 43.9 / 23.1 (−47%) / 15.3 µJ (−65%); per dense-equivalent SOP 64.3 / 33.8 / 22.4 pJ. vs FPT 2023 N-MNIST: ≈330× latency, ≈760× energy, 4–17× fewer LUTs. Repo docs updated (README, fpga/README with the working v5 commands, novelty_check rows, study, superseded banners on results/vivado_2024_1 and results/power_saif; results/*/rtl_perf.json regenerated with the v5 model).
- 2026-10-28 (19:20 IST) · Study · `docs/primer.md` ("HUSH from scratch", 12 sections: one-page summary, basics, gate + proof, training + headroom, hardware, verification, results + 4-level SOTA comparison, why v1 numbers were discarded, open tasks, 10 hard questions, glossary) written for a separate learning chat; also saved to the Claude Project as claude/HUSH_primer.md. study.md stale v1 items updated to v5 and now points to the primer. Task 2 (A4 Spiker+) starts 29 Oct.
- 2026-11-03 · Plan · Decisions with the user: GPU work deferred (reused later), Paper A on simulation + activity-based power (no board), professor wants clear SOTA wins on some axes + real-time inference on a live sensor stream. Plan `docs/plan_nov2026.md`: S0 housekeeping; A5 seeds (CPU background); A4 Spiker+ same chip (Spiker+ uses β = 0.9375 = 1 − 2⁻⁴ and subtract reset = our neuron); A9 real-time (full network on chip, stream mode, streaming testbench; measured stream stats: 27 events/bin mean, 84 max); laptop run L1 (A4 + A9 builds); A6 accuracy; A8 draft by 12 Nov (ISCAS 2027 deadline passed 13 Oct; TCAS-II or FCCM 2027 ≈ 10 Jan). Honest framing recorded: both BASE and HUSH are real-time by >400×, so HUSH's real-time gain is capacity (streams per chip) and dynamic energy, not real-time capability; static power dominates energy per 300 ms window.
- 2026-11-03 · Plan · Added A10 (targeted literature search for FPGA SNN results on N-MNIST / DVS-Gesture; only one N-MNIST row so far) at the user's request; runs alongside A5.
- 2026-11-03 · A10 · `docs/literature/nmnist_dvs_fpga.md`: 4 published N-MNIST FPGA rows besides ours (Cheng et al. TCAS-I 2025, ZCU104, 98.11 %, 81.3k LUT, 0.81 W dyn; FeNN-DMA 2025, KV260, 98.46 %, 55.0k LUT, 0.53 W dyn; arXiv 2603.24891 2026, xcvu9p, 96.4 %, 5.9 ms, 0.31 W ≈ 1.83 mJ; Wu et al. FPT 2023) + one ambiguous row from Wu's table; 5 DVS-Gesture rows (FireFly-S, FireFly v2, Liu IJCNN 2023, 2603.24891, Cheng). Reading: HUSH leads latency 39–330×, energy 80–760× (where computable), dynamic power 11–16×, LUT 4–17×; trails accuracy by 0.4–3.1 pt vs these (two newer designs 98.1–98.5 %). Cheng et al. latency not readable (paywall). Zotero 'HUSH – Literature': 4 items added (A10 tag). A5 trainings running (seeds 1, 2 in parallel).
- 2026-11-03 · A4.1 · spikerplus 2.0.3 installed; its Vivado tutorial generates VHDL (Unlicense / public domain headers, so generated code can be used and published) that compiles in GHDL 4.1 (weight ROMs are Xilinx IP stubs → need behavioural ROMs for simulation and inferred RAMs for our build). Architecture findings that matter for A4.2–A4.5: (1) Spiker+ neuron order differs from ours: at each step start it checks V ≥ θ on the previous potential → fire (subtract θ, no leak that step) else leak (V − V>>4), then adds the weights of active inputs; so spikes appear one step later and the leak is skipped on spiking steps — our weights are not bit-exact on it, accuracy must be re-measured with a bit-exact Python model of its datapath; (2) each layer scans all inputs serially every step that has any input spike (578 cycles for the hidden layer, independent of sparsity) plus a recurrent ('inh') scan over its own 256 neurons with an all-zero weight ROM for a feed-forward LIF layer; expected hidden-layer latency ≈ 100 × (578 + 256 + overhead) ≈ 84k cycles ≈ 0.84 ms at 100 MHz, i.e. ~2.8× slower than our BASE and 5.5–8.6× slower than HUSH (to be confirmed by simulation). Decision: build it as generated (its real behaviour) and report the zero-recurrence scan as a note with the cycle count without it.
- 2026-11-03 14:40 · A5 · First launch was detached (nohup) and was stopped when the reply ended after ~9 min, no output. Relaunched as tracked background jobs, one run per job (scripts/seed_run.sh, run-level resume, unbuffered logs): ungated seeds 1 and 2 now; gated runs follow when each finishes.
- 2026-11-03 16:40 · A5 · Both ungated seed runs stopped at the 2-h background limit after 7/10 epochs (≈ 18 min/epoch with two 1-thread runs in parallel vs ≈ 1.9 min/epoch for one 2-thread run in Oct). No resume (OneCycleLR state not saved), so they restart. Now: one seed at a time, all three runs chained in one job (≈ 55 min, under the limit).
- 2026-11-03 · **A5 DONE** · seeds 1–2 trained (one seed at a time, ~55 min each) + rtl_perf n = 500 → `results/seeds_nmnist.md` (`scripts/seeds_table.py`). Mean ± std over 3 seeds: BASE 97.66 ± 0.06 %; gentle 95.37 ± 0.04 %, 155.4 ± 10.8 µs (1.96 ± 0.13×), reads 0.167 ± 0.001, 23.5 ± 1.6 µJ; aggressive 92.32 ± 0.68 % (seed 2: 91.54 %), 94.7 ± 7.9 µs (3.21 ± 0.28×), reads 0.070 ± 0.003, 14.9 ± 1.2 µJ. Gentle is very stable; aggressive accuracy varies more.
- 2026-11-03 · **A4.2 DONE** · `spikerplus/`: generator wrapper (our INT8 weights → Spiker+ VHDL, fp_dec 6), bit-exact Python model of its datapath, GHDL testbench. Model = generated hardware on 25 random small nets/inputs (output spikes at every step identical; GHDL 4.1). Spiker+ semantics: fire if V > θ at step start (no leak on that step), else leak; then add active inputs' weights; layer l+1 sees layer l one step later. Our ungated seed-0 weights on Spiker+ semantics: **97.53 %** on the full test set (ours 97.59 %) → check passed (≥ 97.0 %); same weights can be used for the same-chip comparison.
- 2026-11-03 18:55 · Audit before A4.3 (user's request): (1) A6 should have started after A5 and had not → started now (`scripts/a6_run.sh`: A6.1 gentler losses exc 0.25 / drive 0.1, and gentle with 12 epochs; then A6.2 hidden 384 ungated + gentle), one thread, so GHDL can use the other core; (2) A4 licence note corrected (generated VHDL is Unlicense); (3) A4.1's 'tutorial testbench runs' check was met with our own GHDL testbench on generated designs (stronger: compared with a bit-exact model), not Spiker+'s tutorial testbench. Everything else in S0, A5, A10.1–A10.3, A4.1–A4.2 verified done; A10.4 (report v3) is part of A8.4 by plan.
- 2026-11-03 19:20 · A4.3 (in progress) · Full 578-256-10 Spiker+ VHDL generated (39 files, 2.5 MB) and simulated in GHDL: sample 0 takes **82,573 cycles** (≈ 826 µs at 100 MHz; my estimate was ≈ 84k). Its output spikes exposed a model error: layer l+1 sees layer l's spikes of the *same* step (delay 0), not one step later — the small random nets could not tell the two apart; with delay 0 all 102 output lines match. Accuracy re-run with the corrected model: still 97.53 %. 20-sample GHDL run started (≈ 66 s per sample).
- 2026-11-03 19:45 · A4.4 · `spikerplus/fpga/top_spiker.vhd` (same harness as top_hush: 20 samples on chip, autorun, all outputs folded into LEDs) checked in GHDL: 2 back-to-back inferences, output spikes bit-exact to the model at every step (102/102 lines each), 83,151 and 82,111 cycles. Vivado flow `build_spiker.tcl` + gate-level tb `tb_spk_net.sv` written (to run in laptop run L1). Fairness note: Spiker+ weights are ROM constants as generated (can only favour it).
- 2026-11-03 20:05 · **A4.3 DONE** · GHDL, full Spiker+ design, the 20 A3 power samples: all 20 bit-exact to the model at every output line, 20/20 classes = model (20/20 correct), **mean 81,422 cycles per inference** (79,027–82,573), i.e. 814 µs at 100 MHz for the whole 578-256-10 network → 2.69× our BASE (302.9 µs), 5.3× HUSH gentle (153.0 µs), 8.4× HUSH aggressive (97.2 µs). `results/spikerplus/ghdl_20.json`.
- 2026-11-03 20:10 · A6.1 · Two new gated points from the seed-0 ungated net (full test set; rtl_perf n = 500): (a) gentler losses (exc 0.25, drive 0.1, 6 ep): **96.12 %**, 212.5 µs (1.43×), column reads 0.310; (b) gentle losses with **12 instead of 6 epochs: 95.73 %, 123.0 µs (2.46×), reads 0.116** — better than the current gentle point on all three axes (95.32 %, 153.0 µs, 0.168); est. energy ≈ 0.151 W × 123 µs ≈ 18.6 µJ (gentle SAIF power reused; a SAIF run would confirm). Target (≥ 96.5 % at reads ≤ 0.25) not reached yet. If (b) becomes the headline point it needs seeds 1–2 (≈ 50 min each) and its own SAIF power (laptop run). A6.2 (hidden 384) started.
- 2026-11-03 21:05 · A6.2 · Hidden 384: ungated **98.00 %** (447.0 µs, +0.41 pt over 256); gated gentle 95.87 %, 221.0 µs (2.02× vs its own BASE, only 1.37× vs the 256 BASE), reads 0.149 → worse than the 256 / 12-epoch point (95.73 %, 123.0 µs). Wider nets raise ungated accuracy but gated accuracy stays at ≈ 95.7–96.1 %: the gap is caused by gating, not capacity. Last A6 run queued: gentler losses for 12 epochs (A6.1c); then A6 stops per plan.
- 2026-11-03 21:55 · **A6.1c meets the A6 target** · gentler losses (exc 0.25, drive 0.1) for 12 epochs: **96.61 %** (full test set), column reads **0.201**, 166.3 µs (1.82× vs BASE), est. ≈ 25 µJ (gentle SAIF power reused). New accuracy–savings front (seed 0): 96.61 % / 1.82× · 95.73 % / 2.46× · 92.72 % / 3.12×. Next for these two new points: seeds 1–2 (running now, scripts/seed_run.sh) and their own SAIF power in laptop run L1.
- 2026-11-03 22:30 · A6 seeds · gentler-12ep seeds 1, 2 and gentle-12ep seed 1 trained (one job, ~33 min each); gentle-12ep seed 2 running. rtl_perf + seed tables follow.
- 2026-11-03 22:40 · **A9.1 DONE** · `scripts/stream_stats.py` → `results/realtime/stream_stats.md` (all 10,000 test samples; work on 500). Per 3 ms bin: raw DVS events mean 41.9 / p99 135 / max 284 (≈ 14 k ev/s mean); active pooled inputs mean 26.5 / p99 66 / max 96 (earlier 200-sample figure 84 corrected). Link needs 0.64 Mbaud at the worst bin (UART at 1 Mbaud OK; 115,200 not). Whole-network cycles per bin: BASE mean 295 / max 828, HUSH gentle mean 185 / max 840 vs 300,000 available → both real-time by ≈ 360× (earlier ">400×" corrected). **Finding: HUSH cuts the mean bin by 37 % but not the worst bin** (busy bins wake most blocks), so a worst-case-provisioned design gains nothing; HUSH's real-time gain is capacity (≈ 1,618 vs 1,016 streams per chip) and dynamic energy. N-MNIST is too light a stream to load the chip. Question raised with the user before building A9.3.
- 2026-11-04 · **A6 seeds DONE** · all three seeds of both new points + rtl_perf n = 500 → `results/seeds_nmnist.md` (scripts/seeds_table.py extended). Gentler 12 ep: **96.55 ± 0.07 %**, 173.7 ± 8.1 µs (1.75 ± 0.08×), reads 0.204 ± 0.003, ≈ 26.2 µJ; gentle 12 ep: **95.74 ± 0.06 %**, 127.7 ± 6.9 µs (2.38 ± 0.12×), reads 0.118 ± 0.002, ≈ 19.3 µJ (energy with the gentle SAIF power; own SAIF in L1). Gentle-12ep dominates the old gentle point on every axis; gentler-12ep holds the A6 target (≥ 96.5 %, reads ≤ 0.25) as a 3-seed mean.
- 2026-11-10 · Plan · Status check (repo in sync with GitHub; remote moved to creagic11/SNN_BTP, URL updated). Overdue: laptop run L1 (6–7 Nov) → A4.5/A4.6/A6.3/A9.5/A9.6 wait. **Real-time decision:** guarantee stated in sensor time (every 3 ms window processed before the next closes; worst ≈ 8.4 µs, both designs), throughput as a separate replay-speed metric at a one-RAMB36 buffer; multi-stream dropped (memory-bound, BASE would hold more streams); heavy stream → Paper B; speedup-vs-activity in limitations. A9.3 corrected: no look-ahead needed. New A9.7 (early-decision accuracy). Calendar re-dated: L1 12–13 Nov, draft ≈ 16 Nov. `docs/plan_nov2026.md` "Update, 10 Nov".
- 2026-11-10 · **A9.2 DONE** · `rtl/hush_net.sv`: hidden layer → spike FIFO (32) + drain (one event per cycle into the output layer's event memory) → output layer (dense, one timestep behind, overlapped) → integer class (= golden predict). hush_layer gains stream ports (avail, out_ready; inert in v5 tops). Checks: 40 random nets bit-exact (+ FIFO depth 4 forcing back-pressure), **4 × 50 N-MNIST samples (base, gentle12, gentler12, aggr): every hidden/output block result and the class bit-exact, cycles = `rtl/sim/net_cycle_model.py` exactly**; regression 80/80. Whole-network latency on chip (3 seeds × 500, `results/net_latency.md`): BASE 279.5 µs, gentler12 159.8 ± 8.1 (1.75×), gentle12 114.9 ± 7.0 (2.44×), aggr 82.9 ± 7.8 (3.39×) — the output layer now costs ≈ 0.3 µs extra instead of ≈ 13–23 µs.
- 2026-11-10 · **A9.3 DONE** · stream mode: sensor front-end in hush_net (raw DVS (x, y, p) → 2×2 pooled index, per-window de-duplication bitmap, 64-entry input FIFO, ring event memory of 1,024 entries = one RAMB18, end-of-window marker writes ts2 and advances avail); hidden layer launches its envelope pass for window w only when w is closed (no look-ahead). `rtl/tb_hush_stream.sv` + `rtl/sim/run_stream.py`: bit-exact to golden at true sensor timing (1 sample, 30 M cycles: per-window delay mean 1.40 µs, max 3.33 µs; decision 0.87 µs after the last window) and at 1,000× / 2,000× replay (5 samples, no drops). Bug found and fixed in the stimulus: an event exactly at a window edge belongs to the next window.
- 2026-11-10 · **L1 package delivered** (141 files, md5-verified on the laptop): `fpga/run_l1.bat` = prep_l1.tcl (4 whole-network power builds base / gentle12 / gentler12 / aggr with 20 samples, 2 stream-mode builds, Spiker+ build) → 5 gate-level SAIF simulations → annotate_l1.tcl (`out_l1/energy_l1.csv`). FPGA top `fpga/top_net.sv` checked in RTL (3 back-to-back inferences, classes = golden, cycles = model + 1 restart cycle; stream top with pseudo-random sensor: no drops). Tcl dry-run with stubbed Vivado commands passed. Waiting for the user to run it.
- 2026-11-10 · **A9.7 DONE** · accuracy vs elapsed sensor time, full test set (`results/realtime/early_decision.json`): at 30 / 60 / 99 / 150 / 201 / 300 ms — BASE 49.6 / 76.0 / 86.1 / 91.8 / 95.4 / 97.58 %; gentler 12 ep 62.3 / 87.7 / 92.6 / 94.2 / 95.4 / 96.61 %; gentle 12 ep 61.0 / 84.9 / 90.9 / 93.1 / 94.3 / 95.73 %; aggressive 53.9 / 79.7 / 86.9 / 89.8 / 91.9 / 92.72 %. **The gated nets are more accurate than BASE for the first ~200 ms** (e.g. 92.6 vs 86.1 % at 99 ms); BASE overtakes only near the end. (BASE final 97.58 vs 97.59 % in metrics.json: a 1-sample difference, cause not yet checked.)
- 2026-11-10 · **A9.4 DONE** · `results/realtime/realtime.md` (RTL, Icarus). (a) True sensor timing, 4 recordings each: all bit-exact, no drops; window delay mean / max: BASE 3.04 / 6.64 µs, HUSH gentle 12 ep 1.47 / 4.50 µs (worst = 0.22 % of a 3 ms window); class 2.03 vs 0.89 µs after the last window; ring peak 127 of 1,024. (b) Replay sweep 250–2,000× on the 20 recordings with the most events (23.7 k raw ev/s, 1.7× the test-set mean), ring 1,024 + FIFO 64: fastest speed passing on all 20 — BASE 750× (17.8 M ev/s), HUSH gentle 1,000× (23.7 M ev/s, 1.33×), gentler 750× (median per-recording limit 1,000×, 1.33×); median per-recording limit HUSH gentle 1,500× = 2.0× BASE. Average-load bound (500 samples, no buffer limit): BASE 1,073×, gentle 2,722×, gentler 1,967×. Overload finding: with the input FIFO full, an end-of-window marker can be dropped and the inference never completes (2 runs at 2,000×) → reserve a FIFO slot for markers (RTL fix before the paper, or state as a limitation).
- 2026-11-10 · A9.3 fix · end-of-window markers can no longer be dropped: input FIFO 128 entries, events may use only 64 (EVQ), so event acceptance is identical to the swept design (all A9.4 results stand) and markers always get a slot. Re-run of the two stalled 2,000× cases: both now complete (events dropped, inference finishes). Note: the L1 stream builds (A9.5, already running) use the earlier 64-entry FIFO; the difference is 64 LUTRAM entries — re-build in the next laptop run, or report with this note.
- 2026-11-10 11:17 · L1 builds done (all 7): whole-network power builds BASE WNS +0.956 ns, 7,745 LUT, 80 BRAM; HUSH (gentle/gentler/aggr) +0.450 ns, 13,885 LUT, 95 BRAM; stream builds BASE +0.309 ns, 8,730 LUT, 48.5 BRAM; HUSH gentle +0.269 ns, 14,593 LUT, 62.5 BRAM. **Spiker+ misses 100 MHz by 0.241 ns** (157 failing endpoints; path: input counter → LUT-ROM weight mux (MUXF7/F8) → adder → membrane register, 13 logic levels) → Fmax ≈ 97.6 MHz; 13,564 LUT, 6,186 FF, 70.5 BRAM. Plan: report Spiker+ at 97.6 MHz (latency 834 µs instead of 814 µs; gate-level SAIF activity is clock-independent), and try a higher-effort implementation in the next laptop run for fairness. Simulations started 11:17.
- 2026-11-10 14:33 · L1 simulations: all four whole-network gate-level runs complete (base 11:17–12:29, gentle12 –13:06, gentler12 –13:50, aggr –14:21), 20 inferences each, every inference = model cycles + 3 (first + 7, reset); SAIF 4.8 / 7.9 / 7.9 / 7.8 MB. Spiker+ simulation started 14:21. (The laptop link dropped briefly around 14:00; the run was unaffected.)
- 2026-11-10 · Check · BASE 97.58 % (hardware rule) vs 97.59 % (metrics.json) explained: the trainer's evaluation uses a float32 key counts·10⁷ + ΣU, which rounds ΣU away at large counts; on BASE seed 0, 2 of 10,000 decisions differ (net +1 sample). The hardware/golden integer rule is the defined behaviour → `scripts/acc_integer.py` recomputes every point and seed with it (results/acc_integer.json) for the paper tables.
- 2026-11-10 · A9.7 analysis (`scripts/early_analysis.py`, 1,000 samples): the gated nets are not earlier because they spike earlier (first output spike: median window 6 vs 5 for BASE) or more (output spikes in the first 99 ms: 39–41 vs 54); BASE's early leader is more often a wrong class (12.3 % of samples at 99 ms vs 8.5–8.8 %). Control queued: the same 12-epoch fine-tune without the gate (`a6_run.sh ctrl12`), to separate "gate-aware training" from "more training".
- 2026-11-10 · A8.2 started: `paper/hush_paperA.tex` (IEEEtran, compiles, 3 pages), all non-L1 numbers in; L1 cells red. L2 package ready (Spiker+ high-effort build; stream builds with the marker fix), dry-run passed; to deliver after L1 ends.
- 2026-11-10 · **Control result (important for the paper)** · BASE fine-tuned for the same 12 extra epochs (lr 0.02) **without the gate reaches 98.08 %** (seed 0, integer rule; BASE 97.58 %). So part of the gated points' accuracy came from the extra training, and the fair ungated baseline is this 22-epoch net: the gate costs 1.5 pt (gentler 96.54 %) / 2.3 pt (gentle 95.74 %), not 1.1 / 1.9. Early decision (10k): control 52.7 / 79.5 / 88.9 / 93.6 / 96.5 / 98.08 % at 30 / 60 / 99 / 150 / 201 / 300 ms vs gentler 62.3 / 87.7 / 92.6 / 94.2 / 95.4 / 96.61 % → the gated nets still lead up to ≈150 ms (+3.7 pt at 99 ms, +8.2 pt at 60 ms), so the early-decision advantage is partly the gate-aware training, not only longer training; the gentler net leads from 21 ms to 156 ms (+9.5 pt at 30 ms), the control leads before 21 ms and from 159 ms. Seeds 1–2 of the control are training.
- 2026-11-10 · Control, 3 seeds: **98.21 ± 0.13 %** (98.08 / 98.22 / 98.33), latency 279.5 µs (same as BASE). It is now the paper's BASE (trained as long as the gated nets); `results/net_latency.md` has accuracy + latency for all points incl. the control. Gate cost vs this BASE: gentler −1.67 pt, gentle −2.47 pt, aggressive −5.9 pt. Draft updated (Table I footnote keeps the 10-epoch 97.66 %; early-decision paragraph rewritten with the control comparison). Note: the ungated hardware at 98.21 % is above Cheng et al. (98.11 %) and below FeNN-DMA (98.46 %) at 280 µs.
- 2026-11-10 · Early-decision analysis redone with the control BASE (1,000 samples): output spikes in the first 99 ms 52 (control) vs 39–41 (gated); wrong leading class at 99 ms 10.6 % vs 8.5–8.8 %. Draft sentence updated.
- 2026-11-10 22:42 · **L1 DONE** (A4.5, A6.3, A9.5) · `results/power_l1/` (README + all reports). Whole-network energy per inference (gate-level SAIF, 20 inferences, nets matched 99.95 %, confidence High, every inference = model + 3 cycles): BASE 42.49 µJ (152 mW, 279.5 µs); HUSH gentler 23.74 µJ (−44 %); gentle 18.44 µJ (−57 %); aggressive 14.39 µJ (−66 %). Spiker+ on the same chip and weights: 311 mW, 818 µs, **254.5 µJ = 13.8× HUSH gentle**, misses 100 MHz by 0.241 ns; its BRAM power alone (140 mW) is 10× ours.
- 2026-11-10 23:00 · Draft updated with all L1 numbers (energy −44 / −57 / −66 % vs BASE; Spiker+ 13.8×; 77–950× less energy than the two SOTA designs with computable energy); no overfull boxes. L2 package (5 files) delivered and md5-verified on the laptop: `run_l2.bat` (≈1–1.5 h) = stream builds with the marker fix + Spiker+ high-effort build.
- 2026-11-10 22:50 · **Deferred to the end (user's request): ask only after every task is finished, or when the user asks what remains:** (1) venue — TCAS-II or FCCM 2027; (2) spelling of the professor's name (Subhra / Shubhra) for the author line.
- 2026-11-10 · **A8.3 internal review done** (fresh-eyes reviewer: number audit + objections). All 20 items addressed in the draft: safety claim scoped to "from the same state"; BASE power vs 22-epoch BASE disclosed (and its own SAIF run added to L2); heuristic-gate caveats (state-free SITRA-inspired proxy, 6-epoch gentle net, top-K reads uncharged, co-training with HUSH); latency basis (20 vs 500 samples) stated; Spiker+ cycle counts reconciled (81.8k harness / 81.4k bare), its timing miss, weights and ratio vs BASE (6.0×); early-decision window limited to ≈140 ms (gentle leads 21–144 ms); real-time claims scoped to RTL simulation and to the average window; SOTA wording ("two larger designs", Wu power range, LUT ratio per design, dynamic power shown); single-seed 384 claim de-causalised; time vs energy granularity explained; loss terms defined from train_snn.py; cycle formula corrected. Draft now 4 pages, no overfull boxes. L2 extended (+ netpwr/base_ctrl SAIF, ≈2.5–3 h total) and re-delivered, 21 files md5-verified.
- 2026-11-11 01:10 · **L2 DONE** · `results/power_l2/`. 22-epoch BASE: 152 mW, 279.5 µs, 42.49 µJ (= 10-epoch BASE; every inference model + 3). Spiker+ with high-effort directives **meets 100 MHz (+0.005 ns)**, 13,548 LUT; reported energy (254.5 µJ, default-effort netlist) is a lower bound (high-effort vectorless +4 %). Stream builds with the marker fix: BASE 8,736 LUT / 48.5 BRAM / +0.252 ns; HUSH gentle 14,606 / 62.5 / +0.256 ns. Draft updated; only the author/affiliation placeholders remain (deferred questions).
- 2026-11-11 · **A9.6 DONE** · real-time energy paragraph in the draft: at sensor speed a 300 ms recording costs ≈ 30.3 mJ static for either design (HUSH saves only 6.7 vs 14.3 µJ dynamic); kept busy at the fastest no-drop replay on the heaviest recordings, a recording costs 61 µJ (BASE, 750×) vs 48 µJ (HUSH gentle, 1,000×).
- 2026-11-11 01:40 · **A8.4 / A10.4 DONE** · Comparison report updated to **v3** (same Claude Doc link): new top section "Update v3 (11 Nov 2026)" with the same-chip table (BASE 22-ep, 3 HUSH points, Spiker+), real-time results, the published-design table, and corrections since v2; title now v3. Plan status and study checklist (Phase 4) updated; project docs synced.
- 2026-11-11 · References: SPARSH authors completed (Matinizadeh, Varshika, Das — Drexel research portal). Still TODO: the authors of "Early" (ICCD 2024, DOI 10.1109/ICCD63220.2024.00100) — not found on open pages; needs IEEE Xplore (institutional access).
- 2026-11-11 · **External review (ChatGPT, first part) — fixes to existing work** (plan confirmed by the user; no new experiments beyond re-analysis):
  - Full-width formal check `formal/fv_width.sv`: RTL `hush_envelope`/`hush_lane` at VB 16, AB 18, K 4, θ 64 for both layers (M = 578, 256): no suppressed spike, U ≤ E, spike ⇒ gate, no wrap-around (vs 8-bit-wider reference), R′ = max V′ restores the hypothesis — PASS (ABC PDR, 72 s); mutant (proxy not bounding weights) FAILs. Width/bound table in `formal/README.md`. First attempt FAILed only because the harness probed a local variable of the module; checking the module's output against a wide reference passes.
  - Scope of the guarantee measured (`scripts/drift.py` → `results/drift.json`, 1,000 samples × 3 points): 0 spikes suppressed vs the ungated update from HUSH's own state; vs the same weights run ungated, trajectories diverge from window 4 (median), 1.2–1.9 % of hidden spike bits differ, same class for 90–96 %.
  - Resource reconciliation `results/resources.md` (power builds hold 20 recordings, ≈ 32.5 BRAM tiles; stream builds hold the ring + front-end).
  - Weight-memory traffic including HUSH's own P/Q reads (2 B per sub-block and input): 0.32–0.45 of BASE (column reads alone 0.07–0.20). Now stated in the paper.
  - Related work corrected per paper: Early 0.54 % mean loss, SITRA 1–2 %, PS4 recomputes failed speculations (no accuracy loss) — the old "all three lose 0.5–2 %" was wrong for PS4. Early's 10 authors filled from Li Jiang's publication page.
  - Paper revised: guarantee scope + figure, full-width proof + widths table, architecture figure, training table, resources table, energy as "active energy per inference" (always-on saving < 0.03 %), real time as "cycle-accurate RTL replay at sensor timing", SOTA comparability paragraph. Heuristic comparison rerun with charged predictor reads on the 12-epoch gentle net, 1,000 samples (running).
- 2026-11-11 · **Second fresh-eyes review applied to Paper A** (all items; no new experiments, only re-analysis of existing results):
  - C1: aggressive point is 6 epochs (others 12): Table II footnote, training table, §VI text.
  - C2: drift reported fully — ungated run of the same weights emits 553 vs 304 hidden spikes (gentle; 658/390 gentler, 388/201 aggressive); removing the gate from the gentle weights lowers accuracy 94.8 → 93.5 % (1,000 samples). Fig. 1 caption and §III updated; Fig. 1 shows both runs from the same V₀ = 0.
  - M1: abstract says "four N-MNIST recordings" for the 4.5 µs figure. M2: "37 %" and "840 vs 828 cycles" (6-epoch weights) replaced by −52 % (1.47 vs 3.04 µs) and the 12-epoch activity buckets (2.2× at 1–9 inputs, 1.59× at ≥ 60).
  - M3: contribution 1 and §V narrowed to the envelope/lane arithmetic under the drive ≤ D_c assumption (discharged by table construction + simulation); F5 = sanity check; m256 = no-wrap only. `formal/README.md` updated.
  - M4: Cheng latency "n/a (not available to us)"; "fully connected" dropped for Cheng/Wu. M5: real-time energy at a common 750× speed: BASE 54.7 µJ, HUSH 47.5 µJ (−13 %); HUSH at 1,000×: 37.3 µJ. M6: N-MNIST cited; Adam, Neftci et al., Smith & Topin, SymbiYosys, Spiker, FireFly added (Spiker/FireFly as arXiv entries from Zotero). M7: Spiker+ "BASE's 10-epoch weights" in the abstract.
  - Minors: q_c defined, block index β, Table I U/E 18 b clipped, Fig. 2 redrawn (g_c to weight RAMs and Finalise, q_c path, V/V′ paths, ring inside event memory, orange only for HUSH additions), Fig. 3 caption seed 0, \ref for sections, SOTA uses stream-build 14.6k LUTs (3.8–5.6×; Wu 2.7–11.3×), heuristic caveats (Early charge lower bound, SITRA-inspired 14 % more bytes, seed 0), "between 21 and 144 ms", "1–9 inputs", 250× replay grid, training model has no 16-bit clip (applied at evaluation), Vivado default directives, code-availability line.
  - Paper now 6 pages (was 5): too long for a TCAS-II brief without cuts; fine for FCCM (venue still to confirm).
- 2026-11-11 22:40 · **Final strict review + figures (user request)** · author line "Anubhav Jha and Rajat Subhra Chakraborty", IIT Kharagpur (departments not given; venue left open; limit 8 pages without references — body is now ≈ 6.5 pages, 7 with references).
  - New figures (`scripts/fig_paper.py`, all from existing result files): Fig. 3 schedule of one timestep (TikZ), Fig. 4 accuracy vs latency with all seeds, Fig. 5 active energy split static/dynamic, Fig. 6 cycles per window vs input activity, Fig. 7 recordings without drops vs replay speed. All figure fonts now embedded as TrueType (no Type 3; IEEE PDF check).
  - Review changes: area cost stated in the abstract, §VI and limitations (+79 % LUT, +19 % BRAM); LUT × latency improves only 3 / 26 / 44 %; two thirds of BASE's active energy is static, dynamic energy alone falls 41–62 %; SnaPEA (ISCA 2018, exact early activation for ReLU CNNs) added to related work and "heuristics" claim limited to SNN schemes; sub-block size 8 stated as unexplored; limitations name the single dataset / single small network; speedup defined against the same seed's ungated net.
- 2026-11-11 23:10 · **Documentation brought to the current state** (user request): `docs/primer.md` rewritten (whole network, fair baseline, scoped guarantee with drift table, two formal checks and their scope, resources, energy split, area × time, real time, heuristic caveats, superseded-numbers list, 15 hard questions, paper → repo map); `study.md` updated (current numbers, superseded items marked, new Phase 6); README and `paper/outline.md` rewritten; `fpga/README.md` (L1/L2 flow), `results/seeds_nmnist.md` (superseded note), supervisor's name corrected to "Rajat Subhra Chakraborty" everywhere. Project docs (plan, primer, study checklist) synced.
