creagic11/SNN_BTP/paper/fig_activity.pdf

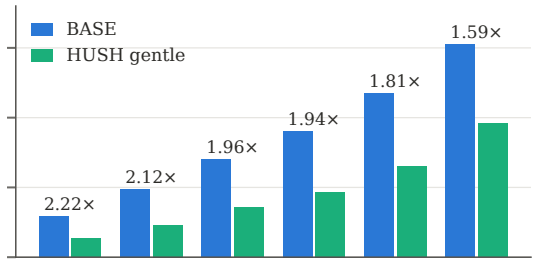
[picture p1: figure]
BASE; HUSH gentle

1–9
21 %

10–19
19 %

20–29
17 %

30–39
17 %

40–59
22 %

≥60
3 %

### Active inputs per 3 ms window (share of windows)

0

200

400

600

Cycles per window
