creagic11/SNN_BTP/paper/fig_front.pdf

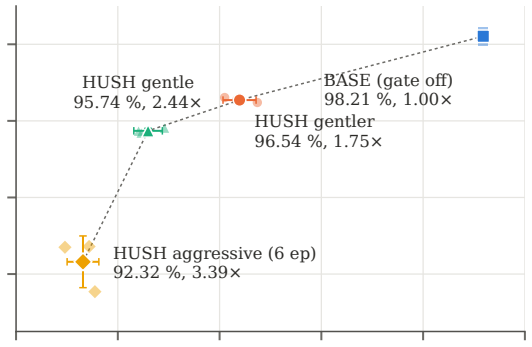
[picture p2: figure]
HUSH gentler; HUSH aggressive (6 ep)

50 | 100 | 150 | 200 | 250 | 300

### Latency per inference (µs)

92

94

96

98

### Test accuracy (%)

HUSH gentle 95.74 %, 2.44× | | BASE (gate off) 98.21 %, 1.00×
