creagic11/SNN_BTP/paper/fig_activity.png

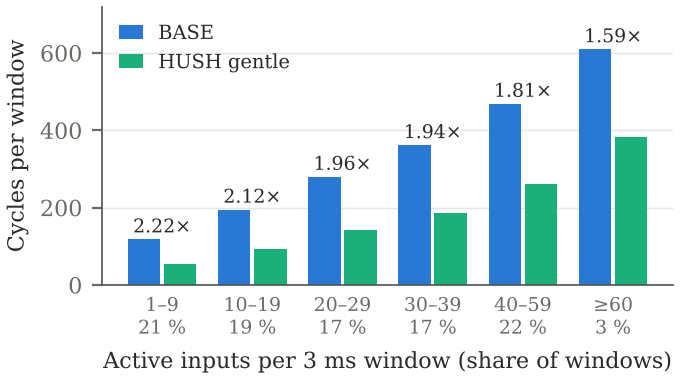
paper/fig_activity.png
