creagic11/SNN_BTP/paper/fig_early.png

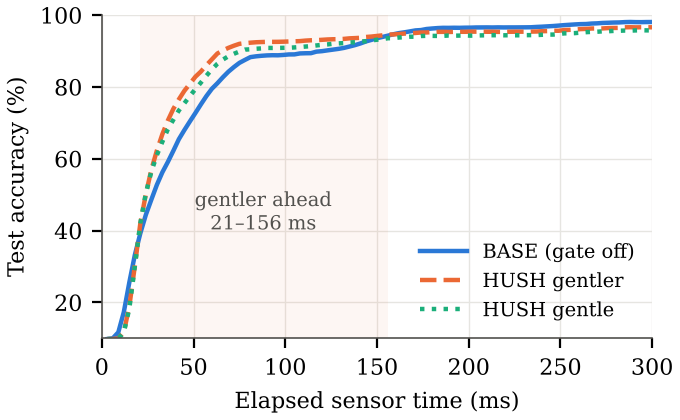
paper/fig_early.png
