creagic11/SNN_BTP/paper/fig_energy.png

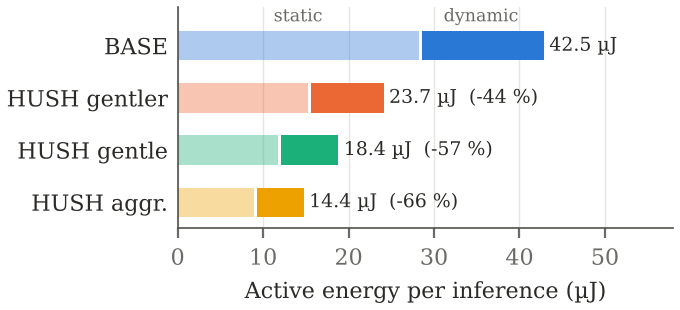
paper/fig_energy.png
