creagic11/SNN_BTP/paper/fig_front.png

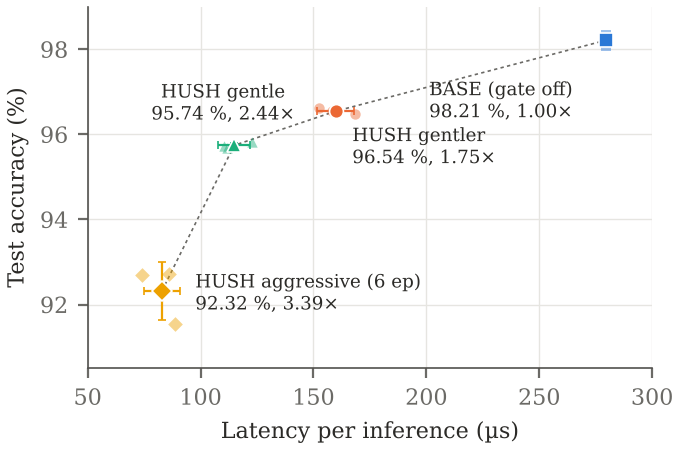
paper/fig_front.png
