creagic11/SNN_BTP/paper/fig_replay.png

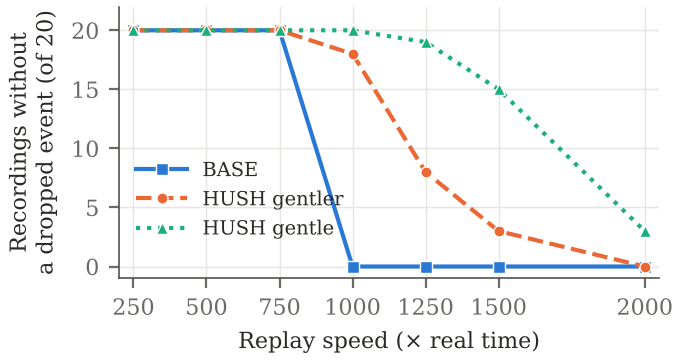
paper/fig_replay.png
