creagic11/SNN_BTP/results/README.md

# Results

All numbers reported in the paper are taken from files in this directory. Accuracies use the hardware's integer
decision rule (most output spikes; ties broken by the larger summed membrane potential, then the lower class index)
on the full 10,000-sample N-MNIST test set.

## Mapping from the paper to the result files

| Paper item | Content | Produced by | Result file |
| --- | --- | --- | --- |
| Fig. 1, Section III | Scope of the safety guarantee; trajectory drift | `scripts/drift.py --n 1000` | `drift.json` |
| Section V, Table I | Formal verification, bit widths and value ranges | `formal/fv_width.sby`, `formal/fv_hush.sby` | `formal/README.md` |
| Section V | Bit-exact and cycle-exact RTL simulation | `rtl/sim/regress.py`, `rtl/sim/run_net.py` | `net/` |
| Table II | Training setup | `train/train_snn.py`, `scripts/seed_run.sh` | `nmnist_T100*/metrics.json`, `logs/` |
| Table III, Fig. 4 | Accuracy, weight-column reads, latency, speedup (three seeds) | `scripts/acc_integer.py`, `scripts/net_perf.py`, `scripts/net_table.py` | `acc_integer.json`, `net_latency.md` |
| Table IV, Fig. 5 | Area, timing, power and energy on the XC7A100T | `fpga/run_l1.bat`, `fpga/run_l2.bat` | `power_l1/`, `power_l2/` |
| Table V | Resource breakdown of the four builds | Vivado `util_hier.rpt` | `resources.md` |
| Table VI | Heuristic gating predictors (exploratory) | `scripts/heuristic_gates.py --match reads` / `--match traffic` | `heuristic_gates.md`, `heuristic_gates_*.json` |
| Section VII, Fig. 6 | Cycles per window against input activity | `scripts/stream_stats.py`, `scripts/activity_buckets.py` | `realtime/stream_stats.md` |
| Section VII, Fig. 7 | Sensor-timing replay and replay-speed sweep | `rtl/sim/run_stream.py`, `scripts/stream_sweep.py`, `scripts/realtime_summary.py` | `realtime/realtime.md`, `realtime/stream_sweep.jsonl` |
| Fig. 8 | Accuracy against elapsed sensor time | `scripts/early_decision.py`, `scripts/early_analysis.py` | `realtime/early_decision.json`, `realtime/early_analysis.json` |
| Spiker+ rows | Same-device external baseline | `spikerplus/` | `spikerplus/`, `power_l1/spiker/`, `power_l2/spiker_hi/` |

Figures 4–7 are generated by `scripts/fig_paper.py` and Fig. 8 by `scripts/fig_early.py`.

## Trained networks

Each run directory holds `weights.npz` (INT8 weights and neuron parameters), `metrics.json` (per-epoch training
record) and, where measured, `net_perf.json` (whole-network latency and reads from the cycle model), `rtl_perf.json`
(hidden-layer cycle model) and `rho.json` (sleep statistics). The training log of a run `<tag>` is
`logs/train_<tag>.log`. Seeds 1 and 2 carry the suffixes `_s1` and `_s2`; no suffix denotes seed 0.

| Directory | Network |
| --- | --- |
| `nmnist_T100` | Ungated 578-256-10 network, 10 epochs (starting point of all gated networks; weights used for Spiker+) |
| `nmnist_T100_ft12_ctrl` | BASE of the paper: the 10-epoch network trained for 12 further epochs without the gate (98.21 %) |
| `nmnist_T100_mf_e025_d01_ep12` | HUSH gentler: mean-field gate, λ_e = 0.25, λ_d = 0.1, 12 fine-tuning epochs |
| `nmnist_T100_mf_e05_d025_ep12` | HUSH gentle: λ_e = 0.5, λ_d = 0.25, 12 fine-tuning epochs |
| `nmnist_T100_mf_e2_d1` | HUSH aggressive: λ_e = 2, λ_d = 1, 6 fine-tuning epochs |
| `nmnist_T100_mf_e05_d025` | Gentle setting with 6 fine-tuning epochs (superseded by the 12-epoch network) |
| `nmnist_T100_mf_e025_d01`, `nmnist_T100_mf_e0.1_d0`, `nmnist_T100_mf_e0.25_d0` | Single-seed exploration of the penalty weights |
| `nmnist_T100_h384`, `nmnist_T100_h384_mf_e05_d025` | Wider hidden layer (384 neurons), ungated and gated |
| `shd_*` | Spiking Heidelberg Digits study: feed-forward (`shd_T250*`), recurrent adaptive LIF (`shd_rec*`) and axonal-delay (`shd_delay*`) networks; see `regime_study.md` and `docs/headroom_model.md` |
| `mnist_400` | Rate-coded MNIST 784-400-10 network of the feasibility study; see `rho_unclustered.md` |

## Reports

| File | Content |
| --- | --- |
| `net_latency.md` | Whole-network latency per inference, three seeds × 500 test samples |
| `acc_integer.json` | Test accuracy of every network with the integer decision rule |
| `resources.md` | Per-module resources of the two power builds and the two stream builds |
| `drift.json` | Per-timestep safety violations (none) and trajectory divergence between gated and ungated runs |
| `heuristic_gates.md` | HUSH against heuristic predictors on the same networks |
| `seeds_nmnist.md` | Accuracy and column reads over three seeds (latency and energy columns superseded by `net_latency.md` and `power_l1/`) |
| `power_l1/README.md`, `power_l2/README.md` | Vivado implementation runs: area, timing, gate-level power, energy |
| `realtime/` | Stream statistics, sensor-timing replay, replay-speed sweep, accuracy against elapsed time |
| `net/` | Bit-exact whole-network simulations (four networks × 50 samples) and the 80-case randomised regression |
| `spikerplus/` | Spiker+ accuracy on our weights and its GHDL simulation of 20 samples |
| `G0_report.md` | Feasibility study and the decision to focus on event-driven workloads |
| `regime_study.md` | Spiking Heidelberg Digits study: where hibernation pays |
| `rho_unclustered.md` | Rate-coded MNIST: sleep fraction before and after neuron clustering |
| `synth_yosys.md` | Early resource estimate with open-source synthesis (superseded) |
| `logs/` | Training and sweep logs |
| `archive/` | Superseded hardware runs and exploratory ablations; see `archive/README.md` |
