creagic11/SNN_BTP/results/power_l1/energy_l1.csv

case | inferences | mean_cycles | latency_us | total_mW | dynamic_mW | static_mW | E_total_uJ | E_dyn_uJ | nets_matched
netpwr/base | 20 | 27952.4 | 279.52 | 152 | 51 | 101 | 42.49 | 14.26 | 100% (22039/22058)
netpwr/mf_gentle12 | 20 | 11526.6 | 115.27 | 160 | 58 | 102 | 18.44 | 6.69 | 100% (39235/39254)
netpwr/mf_gentler12 | 20 | 15122.5 | 151.22 | 157 | 56 | 102 | 23.74 | 8.47 | 100% (39235/39254)
netpwr/mf_aggr | 20 | 8773.1 | 87.73 | 164 | 62 | 102 | 14.39 | 5.44 | 100% (39235/39254)
spiker | 20 | 81843.5 | 818.44 | 311 | 210 | 101 | 254.53 | 171.87 | 100% (33697/33697)
