creagic11/SNN_BTP/paper/fig_early.pdf

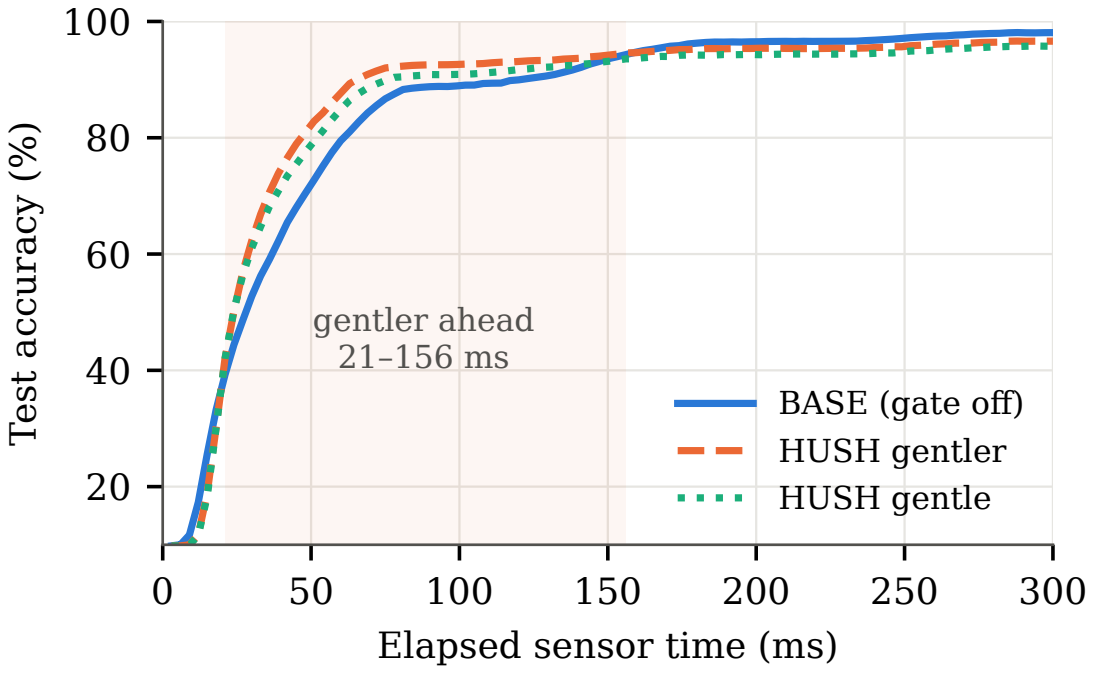
[picture p8: page 1]
Test accuracy (%)

gentler ahead 21–156 ms

BASE (gate off) HUSH gentler

HUSH gentle

Elapsed sensor time (ms)
