creagic11/SNN_BTP/paper/fig_replay.pdf

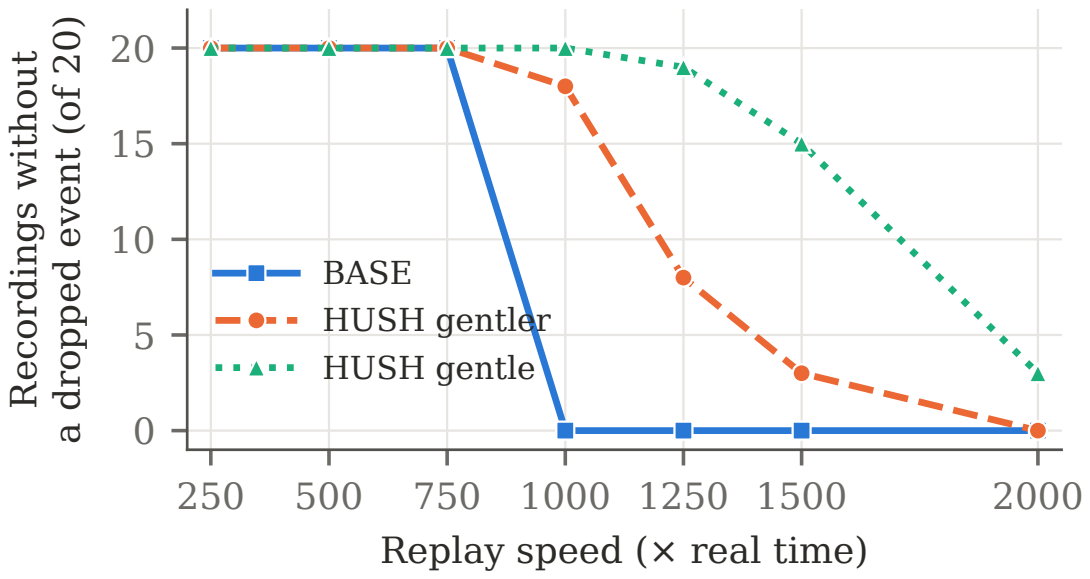
[picture p9: page 1]
Recordings without; BASE HUSH gentler HUSH gentle

a dropped event (of 20)

Replay speed (× real time)
