creagic11/SNN_BTP/spikerplus/fpga/nexys_spiker.xdc

## Nexys A7-100T: 100 MHz clock, CPU reset button, 8 LEDs
set_property -dict { PACKAGE_PIN E3  IOSTANDARD LVCMOS33 } [get_ports clk100]
create_clock -add -name sys_clk -period 10.000 -waveform {0 5} [get_ports clk100]
set_property -dict { PACKAGE_PIN C12 IOSTANDARD LVCMOS33 } [get_ports cpu_resetn]
set_property -dict { PACKAGE_PIN H17 IOSTANDARD LVCMOS33 } [get_ports {led[0]}]
set_property -dict { PACKAGE_PIN K15 IOSTANDARD LVCMOS33 } [get_ports {led[1]}]
set_property -dict { PACKAGE_PIN J13 IOSTANDARD LVCMOS33 } [get_ports {led[2]}]
set_property -dict { PACKAGE_PIN N14 IOSTANDARD LVCMOS33 } [get_ports {led[3]}]
set_property -dict { PACKAGE_PIN R18 IOSTANDARD LVCMOS33 } [get_ports {led[4]}]
set_property -dict { PACKAGE_PIN V17 IOSTANDARD LVCMOS33 } [get_ports {led[5]}]
set_property -dict { PACKAGE_PIN U17 IOSTANDARD LVCMOS33 } [get_ports {led[6]}]
set_property -dict { PACKAGE_PIN U16 IOSTANDARD LVCMOS33 } [get_ports {led[7]}]
set_property CONFIG_VOLTAGE 3.3 [current_design]
set_property CFGBVS VCCO [current_design]
## USB-UART (FTDI TX -> FPGA RX): host load port
