creagic11/SNN_BTP/spikerplus/fpga/gen/layer_256_neurons_578_inputs.vhd

---------------------------------------------------------------------------------
-- This is free and unencumbered software released into the public domain.
--
-- Anyone is free to copy, modify, publish, use, compile, sell, or
-- distribute this software, either in source code form or as a compiled
-- binary, for any purpose, commercial or non-commercial, and by any
-- means.
--
-- In jurisdictions that recognize copyright laws, the author or authors
-- of this software dedicate any and all copyright interest in the
-- software to the public domain. We make this dedication for the benefit
-- of the public at large and to the detriment of our heirs and
-- successors. We intend this dedication to be an overt act of
-- relinquishment in perpetuity of all present and future rights to this
-- software under copyright law.
--
-- THE SOFTWARE IS PROVIDED "AS IS", WITHOUT WARRANTY OF ANY KIND,
-- EXPRESS OR IMPLIED, INCLUDING BUT NOT LIMITED TO THE WARRANTIES OF
-- MERCHANTABILITY, FITNESS FOR A PARTICULAR PURPOSE AND NONINFRINGEMENT.
-- IN NO EVENT SHALL THE AUTHORS BE LIABLE FOR ANY CLAIM, DAMAGES OR
-- OTHER LIABILITY, WHETHER IN AN ACTION OF CONTRACT, TORT OR OTHERWISE,
-- ARISING FROM, OUT OF OR IN CONNECTION WITH THE SOFTWARE OR THE USE OR
-- OTHER DEALINGS IN THE SOFTWARE.
--
-- For more information, please refer to <http://unlicense.org/>
---------------------------------------------------------------------------------


library ieee;
use ieee.std_logic_1164.all;
use ieee.numeric_std.all;
library work;
use work.spiker_pkg.all;


entity layer_256_neurons_578_inputs is
    generic (
        n_exc_inputs : integer := 578;
        n_inh_inputs : integer := 256;
        exc_cnt_bitwidth : integer := 10;
        inh_cnt_bitwidth : integer := 8;
        neuron_bit_width : integer := 16;
        inh_weights_bit_width : integer := 8;
        exc_weights_bit_width : integer := 8;
        shift : integer := 4
    );
    port (
        clk : in std_logic;
        rst_n : in std_logic;
        start : in std_logic;
        restart : in std_logic;
        exc_spikes : in std_logic_vector(n_exc_inputs-1 downto 0);
        inh_spikes : in std_logic_vector(n_inh_inputs-1 downto 0);
        ready : out std_logic;
        out_spikes : out std_logic_vector(255 downto 0)
    );
end entity layer_256_neurons_578_inputs;

architecture behavior of layer_256_neurons_578_inputs is


    constant v_th_00 : signed(neuron_bit_width-1 downto 0) := "0000000001000000";
    constant v_th_01 : signed(neuron_bit_width-1 downto 0) := "0000000001000000";
    constant v_th_02 : signed(neuron_bit_width-1 downto 0) := "0000000001000000";
    constant v_th_03 : signed(neuron_bit_width-1 downto 0) := "0000000001000000";
    constant v_th_04 : signed(neuron_bit_width-1 downto 0) := "0000000001000000";
    constant v_th_05 : signed(neuron_bit_width-1 downto 0) := "0000000001000000";
    constant v_th_06 : signed(neuron_bit_width-1 downto 0) := "0000000001000000";
    constant v_th_07 : signed(neuron_bit_width-1 downto 0) := "0000000001000000";
    constant v_th_08 : signed(neuron_bit_width-1 downto 0) := "0000000001000000";
    constant v_th_09 : signed(neuron_bit_width-1 downto 0) := "0000000001000000";
    constant v_th_0a : signed(neuron_bit_width-1 downto 0) := "0000000001000000";
    constant v_th_0b : signed(neuron_bit_width-1 downto 0) := "0000000001000000";
    constant v_th_0c : signed(neuron_bit_width-1 downto 0) := "0000000001000000";
    constant v_th_0d : signed(neuron_bit_width-1 downto 0) := "0000000001000000";
    constant v_th_0e : signed(neuron_bit_width-1 downto 0) := "0000000001000000";
    constant v_th_0f : signed(neuron_bit_width-1 downto 0) := "0000000001000000";
    constant v_th_10 : signed(neuron_bit_width-1 downto 0) := "0000000001000000";
    constant v_th_11 : signed(neuron_bit_width-1 downto 0) := "0000000001000000";
    constant v_th_12 : signed(neuron_bit_width-1 downto 0) := "0000000001000000";
    constant v_th_13 : signed(neuron_bit_width-1 downto 0) := "0000000001000000";
    constant v_th_14 : signed(neuron_bit_width-1 downto 0) := "0000000001000000";
    constant v_th_15 : signed(neuron_bit_width-1 downto 0) := "0000000001000000";
    constant v_th_16 : signed(neuron_bit_width-1 downto 0) := "0000000001000000";
    constant v_th_17 : signed(neuron_bit_width-1 downto 0) := "0000000001000000";
    constant v_th_18 : signed(neuron_bit_width-1 downto 0) := "0000000001000000";
    constant v_th_19 : signed(neuron_bit_width-1 downto 0) := "0000000001000000";
    constant v_th_1a : signed(neuron_bit_width-1 downto 0) := "0000000001000000";
    constant v_th_1b : signed(neuron_bit_width-1 downto 0) := "0000000001000000";
    constant v_th_1c : signed(neuron_bit_width-1 downto 0) := "0000000001000000";
    constant v_th_1d : signed(neuron_bit_width-1 downto 0) := "0000000001000000";
    constant v_th_1e : signed(neuron_bit_width-1 downto 0) := "0000000001000000";
    constant v_th_1f : signed(neuron_bit_width-1 downto 0) := "0000000001000000";
    constant v_th_20 : signed(neuron_bit_width-1 downto 0) := "0000000001000000";
    constant v_th_21 : signed(neuron_bit_width-1 downto 0) := "0000000001000000";
    constant v_th_22 : signed(neuron_bit_width-1 downto 0) := "0000000001000000";
    constant v_th_23 : signed(neuron_bit_width-1 downto 0) := "0000000001000000";
    constant v_th_24 : signed(neuron_bit_width-1 downto 0) := "0000000001000000";
    constant v_th_25 : signed(neuron_bit_width-1 downto 0) := "0000000001000000";
    constant v_th_26 : signed(neuron_bit_width-1 downto 0) := "0000000001000000";
    constant v_th_27 : signed(neuron_bit_width-1 downto 0) := "0000000001000000";
    constant v_th_28 : signed(neuron_bit_width-1 downto 0) := "0000000001000000";
    constant v_th_29 : signed(neuron_bit_width-1 downto 0) := "0000000001000000";
    constant v_th_2a : signed(neuron_bit_width-1 downto 0) := "0000000001000000";
    constant v_th_2b : signed(neuron_bit_width-1 downto 0) := "0000000001000000";
    constant v_th_2c : signed(neuron_bit_width-1 downto 0) := "0000000001000000";
    constant v_th_2d : signed(neuron_bit_width-1 downto 0) := "0000000001000000";
    constant v_th_2e : signed(neuron_bit_width-1 downto 0) := "0000000001000000";
    constant v_th_2f : signed(neuron_bit_width-1 downto 0) := "0000000001000000";
    constant v_th_30 : signed(neuron_bit_width-1 downto 0) := "0000000001000000";
    constant v_th_31 : signed(neuron_bit_width-1 downto 0) := "0000000001000000";
    constant v_th_32 : signed(neuron_bit_width-1 downto 0) := "0000000001000000";
    constant v_th_33 : signed(neuron_bit_width-1 downto 0) := "0000000001000000";
    constant v_th_34 : signed(neuron_bit_width-1 downto 0) := "0000000001000000";
    constant v_th_35 : signed(neuron_bit_width-1 downto 0) := "0000000001000000";
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
    constant v_th_f9 : signed(neuron_bit_width-1 downto 0) := "0000000001000000";
    constant v_th_fa : signed(neuron_bit_width-1 downto 0) := "0000000001000000";
    constant v_th_fb : signed(neuron_bit_width-1 downto 0) := "0000000001000000";
    constant v_th_fc : signed(neuron_bit_width-1 downto 0) := "0000000001000000";
    constant v_th_fd : signed(neuron_bit_width-1 downto 0) := "0000000001000000";
    constant v_th_fe : signed(neuron_bit_width-1 downto 0) := "0000000001000000";
    constant v_th_ff : signed(neuron_bit_width-1 downto 0) := "0000000001000000";

    component multi_input_578_exc_256_inh is
        generic (
            n_exc_inputs : integer := 578;
            n_inh_inputs : integer := 256;
            exc_cnt_bitwidth : integer := 10;
            inh_cnt_bitwidth : integer := 8
        );
        port (
            clk : in std_logic;
            rst_n : in std_logic;
            restart : in std_logic;
            start : in std_logic;
            exc_spikes : in std_logic_vector(n_exc_inputs-1 downto 0);
            inh_spikes : in std_logic_vector(n_inh_inputs-1 downto 0);
            neurons_ready : in std_logic;
            exc_cnt : out std_logic_vector(exc_cnt_bitwidth - 1 downto 0);
            inh_cnt : out std_logic_vector(inh_cnt_bitwidth - 1 downto 0);
            ready : out std_logic;
            neuron_restart : out std_logic;
            exc : out std_logic;
            inh : out std_logic;
            out_sample : out std_logic;
            exc_spike : out std_logic;
            inh_spike : out std_logic
        );
    end component;

    component neuron_subtractive is
        generic (
            neuron_bit_width : integer := 16;
            inh_weights_bit_width : integer := 8;
            exc_weights_bit_width : integer := 8;
            shift : integer := 4
        );
        port (
            v_th : in signed(neuron_bit_width-1 downto 0);
            inh_weight : in signed(inh_weights_bit_width-1 downto 0);
            exc_weight : in signed(exc_weights_bit_width-1 downto 0);
            clk : in std_logic;
            rst_n : in std_logic;
            restart : in std_logic;
            exc : in std_logic;
            inh : in std_logic;
            exc_spike : in std_logic;
            inh_spike : in std_logic;
            neuron_ready : out std_logic;
            out_spike : out std_logic
        );
    end component;

    component rom_578x256_exclif1 is
        port (
            clka : in std_logic;
            addra : in std_logic_vector(9 downto 0);
            dout_00 : out std_logic_vector(7 downto 0);
            dout_01 : out std_logic_vector(7 downto 0);
            dout_02 : out std_logic_vector(7 downto 0);
            dout_03 : out std_logic_vector(7 downto 0);
            dout_04 : out std_logic_vector(7 downto 0);
            dout_05 : out std_logic_vector(7 downto 0);
            dout_06 : out std_logic_vector(7 downto 0);
            dout_07 : out std_logic_vector(7 downto 0);
            dout_08 : out std_logic_vector(7 downto 0);
            dout_09 : out std_logic_vector(7 downto 0);
            dout_0a : out std_logic_vector(7 downto 0);
            dout_0b : out std_logic_vector(7 downto 0);
            dout_0c : out std_logic_vector(7 downto 0);
            dout_0d : out std_logic_vector(7 downto 0);
            dout_0e : out std_logic_vector(7 downto 0);
            dout_0f : out std_logic_vector(7 downto 0);
            dout_10 : out std_logic_vector(7 downto 0);
            dout_11 : out std_logic_vector(7 downto 0);
            dout_12 : out std_logic_vector(7 downto 0);
            dout_13 : out std_logic_vector(7 downto 0);
            dout_14 : out std_logic_vector(7 downto 0);
            dout_15 : out std_logic_vector(7 downto 0);
            dout_16 : out std_logic_vector(7 downto 0);
            dout_17 : out std_logic_vector(7 downto 0);
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
        );
    end component;

    component addr_converter is
        generic (
            N : integer := 10
        );
        port (
            addr_in : in std_logic_vector(N-1 downto 0);
            addr_out : out std_logic_vector(N-1 downto 0)
        );
    end component;

    component barrier is
        generic (
            N : integer := 256
        );
        port (
            clk : in std_logic;
            rst_n : in std_logic;
            restart : in std_logic;
            out_sample : in std_logic;
            reg_in : in std_logic_vector(N-1 downto 0);
            ready : out std_logic;
            reg_out : out std_logic_vector(N-1 downto 0)
        );
    end component;


    signal start_neurons : std_logic;
    signal neurons_restart : std_logic;
    signal neurons_ready : std_logic;
    signal exc : std_logic;
    signal inh : std_logic;
    signal exc_spike : std_logic;
    signal inh_spike : std_logic;
    signal exc_cnt : std_logic_vector(exc_cnt_bitwidth - 1 downto 0);
    signal inh_cnt : std_logic_vector(inh_cnt_bitwidth - 1 downto 0);
    signal exc_addr : std_logic_vector(exc_cnt_bitwidth - 1 downto 0);
    signal inh_addr : std_logic_vector(inh_cnt_bitwidth - 1 downto 0);
    signal neuron_restart : std_logic;
    signal barrier_ready : std_logic;
    signal out_spikes_inst : std_logic_vector(255 downto 0);
    signal out_sample : std_logic;
    signal neuron_ready_00 : std_logic;
    signal inh_weight_00 : std_logic_vector(inh_weights_bit_width-1 downto 0);
    signal exc_weight_00 : std_logic_vector(exc_weights_bit_width-1 downto 0);
    signal neuron_ready_01 : std_logic;
    signal inh_weight_01 : std_logic_vector(inh_weights_bit_width-1 downto 0);
    signal exc_weight_01 : std_logic_vector(exc_weights_bit_width-1 downto 0);
    signal neuron_ready_02 : std_logic;
    signal inh_weight_02 : std_logic_vector(inh_weights_bit_width-1 downto 0);
    signal exc_weight_02 : std_logic_vector(exc_weights_bit_width-1 downto 0);
    signal neuron_ready_03 : std_logic;
    signal inh_weight_03 : std_logic_vector(inh_weights_bit_width-1 downto 0);
    signal exc_weight_03 : std_logic_vector(exc_weights_bit_width-1 downto 0);
    signal neuron_ready_04 : std_logic;
    signal inh_weight_04 : std_logic_vector(inh_weights_bit_width-1 downto 0);
    signal exc_weight_04 : std_logic_vector(exc_weights_bit_width-1 downto 0);
    signal neuron_ready_05 : std_logic;
    signal inh_weight_05 : std_logic_vector(inh_weights_bit_width-1 downto 0);
    signal exc_weight_05 : std_logic_vector(exc_weights_bit_width-1 downto 0);
    signal neuron_ready_06 : std_logic;
    signal inh_weight_06 : std_logic_vector(inh_weights_bit_width-1 downto 0);
    signal exc_weight_06 : std_logic_vector(exc_weights_bit_width-1 downto 0);
    signal neuron_ready_07 : std_logic;
    signal inh_weight_07 : std_logic_vector(inh_weights_bit_width-1 downto 0);
    signal exc_weight_07 : std_logic_vector(exc_weights_bit_width-1 downto 0);
    signal neuron_ready_08 : std_logic;
    signal inh_weight_08 : std_logic_vector(inh_weights_bit_width-1 downto 0);
    signal exc_weight_08 : std_logic_vector(exc_weights_bit_width-1 downto 0);
    signal neuron_ready_09 : std_logic;
    signal inh_weight_09 : std_logic_vector(inh_weights_bit_width-1 downto 0);
    signal exc_weight_09 : std_logic_vector(exc_weights_bit_width-1 downto 0);
    signal neuron_ready_0a : std_logic;
    signal inh_weight_0a : std_logic_vector(inh_weights_bit_width-1 downto 0);
    signal exc_weight_0a : std_logic_vector(exc_weights_bit_width-1 downto 0);
    signal neuron_ready_0b : std_logic;
    signal inh_weight_0b : std_logic_vector(inh_weights_bit_width-1 downto 0);
    signal exc_weight_0b : std_logic_vector(exc_weights_bit_width-1 downto 0);
    signal neuron_ready_0c : std_logic;
    signal inh_weight_0c : std_logic_vector(inh_weights_bit_width-1 downto 0);
    signal exc_weight_0c : std_logic_vector(exc_weights_bit_width-1 downto 0);
    signal neuron_ready_0d : std_logic;
    signal inh_weight_0d : std_logic_vector(inh_weights_bit_width-1 downto 0);
    signal exc_weight_0d : std_logic_vector(exc_weights_bit_width-1 downto 0);
    signal neuron_ready_0e : std_logic;
    signal inh_weight_0e : std_logic_vector(inh_weights_bit_width-1 downto 0);
    signal exc_weight_0e : std_logic_vector(exc_weights_bit_width-1 downto 0);
    signal neuron_ready_0f : std_logic;
    signal inh_weight_0f : std_logic_vector(inh_weights_bit_width-1 downto 0);
    signal exc_weight_0f : std_logic_vector(exc_weights_bit_width-1 downto 0);
    signal neuron_ready_10 : std_logic;
    signal inh_weight_10 : std_logic_vector(inh_weights_bit_width-1 downto 0);
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
    signal neuron_ready_f8 : std_logic;
    signal inh_weight_f8 : std_logic_vector(inh_weights_bit_width-1 downto 0);
    signal exc_weight_f8 : std_logic_vector(exc_weights_bit_width-1 downto 0);
    signal neuron_ready_f9 : std_logic;
    signal inh_weight_f9 : std_logic_vector(inh_weights_bit_width-1 downto 0);
    signal exc_weight_f9 : std_logic_vector(exc_weights_bit_width-1 downto 0);
    signal neuron_ready_fa : std_logic;
    signal inh_weight_fa : std_logic_vector(inh_weights_bit_width-1 downto 0);
    signal exc_weight_fa : std_logic_vector(exc_weights_bit_width-1 downto 0);
    signal neuron_ready_fb : std_logic;
    signal inh_weight_fb : std_logic_vector(inh_weights_bit_width-1 downto 0);
    signal exc_weight_fb : std_logic_vector(exc_weights_bit_width-1 downto 0);
    signal neuron_ready_fc : std_logic;
    signal inh_weight_fc : std_logic_vector(inh_weights_bit_width-1 downto 0);
    signal exc_weight_fc : std_logic_vector(exc_weights_bit_width-1 downto 0);
    signal neuron_ready_fd : std_logic;
    signal inh_weight_fd : std_logic_vector(inh_weights_bit_width-1 downto 0);
    signal exc_weight_fd : std_logic_vector(exc_weights_bit_width-1 downto 0);
    signal neuron_ready_fe : std_logic;
    signal inh_weight_fe : std_logic_vector(inh_weights_bit_width-1 downto 0);
    signal exc_weight_fe : std_logic_vector(exc_weights_bit_width-1 downto 0);
    signal neuron_ready_ff : std_logic;
    signal inh_weight_ff : std_logic_vector(inh_weights_bit_width-1 downto 0);
    signal exc_weight_ff : std_logic_vector(exc_weights_bit_width-1 downto 0);
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
