creagic11/SNN_BTP/spikerplus/fpga/gen/multi_input_dp_256_exc_10_inh.vhd

---------------------------------------------------------------------------------
-- This is free and unencumbered software released into the public domain.
--
-- Anyone is free to copy, modify, publish, use, compile, sell, or
-- distribute this software, either in source code form or as a compiled
-- binary, for any purpose, commercial or non-commercial, and by any
-- means.
--
-- In jurisdictions that recognize copyright laws, the author or authors
-- of this software dedicate any and all copyright interest in the
-- software to the public domain. We make this dedication for the benefit
-- of the public at large and to the detriment of our heirs and
-- successors. We intend this dedication to be an overt act of
-- relinquishment in perpetuity of all present and future rights to this
-- software under copyright law.
--
-- THE SOFTWARE IS PROVIDED "AS IS", WITHOUT WARRANTY OF ANY KIND,
-- EXPRESS OR IMPLIED, INCLUDING BUT NOT LIMITED TO THE WARRANTIES OF
-- MERCHANTABILITY, FITNESS FOR A PARTICULAR PURPOSE AND NONINFRINGEMENT.
-- IN NO EVENT SHALL THE AUTHORS BE LIABLE FOR ANY CLAIM, DAMAGES OR
-- OTHER LIABILITY, WHETHER IN AN ACTION OF CONTRACT, TORT OR OTHERWISE,
-- ARISING FROM, OUT OF OR IN CONNECTION WITH THE SOFTWARE OR THE USE OR
-- OTHER DEALINGS IN THE SOFTWARE.
--
-- For more information, please refer to <http://unlicense.org/>
---------------------------------------------------------------------------------


library ieee;
use ieee.std_logic_1164.all;
use ieee.numeric_std.all;


entity multi_input_dp_256_exc_10_inh is
    generic (
        n_exc_inputs : integer := 256;
        n_inh_inputs : integer := 10;
        exc_cnt_bitwidth : integer := 8;
        inh_cnt_bitwidth : integer := 4
    );
    port (
        clk : in std_logic;
        exc_spikes : in std_logic_vector(n_exc_inputs-1 downto 0);
        inh_spikes : in std_logic_vector(n_inh_inputs-1 downto 0);
        exc_sample : in std_logic;
        exc_rst_n : in std_logic;
        exc_cnt_en : in std_logic;
        exc_cnt_rst_n : in std_logic;
        inh_sample : in std_logic;
        inh_rst_n : in std_logic;
        inh_cnt_en : in std_logic;
        inh_cnt_rst_n : in std_logic;
        exc_yes : out std_logic;
        exc_spike : out std_logic;
        exc_stop : out std_logic;
        exc_cnt : out std_logic_vector(exc_cnt_bitwidth - 1 downto 0);
        inh_yes : out std_logic;
        inh_spike : out std_logic;
        inh_stop : out std_logic;
        inh_cnt : out std_logic_vector(inh_cnt_bitwidth - 1 downto 0)
    );
end entity multi_input_dp_256_exc_10_inh;

architecture behavior of multi_input_dp_256_exc_10_inh is


    component generic_or is
        generic (
            N : integer := 256
        );
        port (
            or_in : in std_logic_vector(N-1 downto 0);
            or_out : out std_logic
        );
    end component;

    component reg_sync_rst is
        generic (
            N : integer := 256
        );
        port (
            clk : in std_logic;
            en : in std_logic;
            rst_n : in std_logic;
            reg_in : in std_logic_vector(N-1 downto 0);
            reg_out : out std_logic_vector(N-1 downto 0)
        );
    end component;

    component cnt is
        generic (
            N : integer := 8;
            rst_value : integer := 0
        );
        port (
            clk : in std_logic;
            cnt_en : in std_logic;
            cnt_rst_n : in std_logic;
            cnt_out : out std_logic_vector(N-1 downto 0)
        );
    end component;

    component cmp_eq is
        generic (
            N : integer := 8
        );
        port (
            in0 : in std_logic_vector(N-1 downto 0);
            in1 : in std_logic_vector(N-1 downto 0);
            cmp_out : out std_logic
        );
    end component;

    component mux_256to1 is
        port (
            mux_sel : in std_logic_vector(7 downto 0);
            in0 : in std_logic;
            in1 : in std_logic;
            in2 : in std_logic;
            in3 : in std_logic;
            in4 : in std_logic;
            in5 : in std_logic;
            in6 : in std_logic;
            in7 : in std_logic;
            in8 : in std_logic;
            in9 : in std_logic;
            in10 : in std_logic;
            in11 : in std_logic;
            in12 : in std_logic;
            in13 : in std_logic;
            in14 : in std_logic;
            in15 : in std_logic;
            in16 : in std_logic;
            in17 : in std_logic;
            in18 : in std_logic;
            in19 : in std_logic;
            in20 : in std_logic;
            in21 : in std_logic;
            in22 : in std_logic;
            in23 : in std_logic;
            in24 : in std_logic;
            in25 : in std_logic;
            in26 : in std_logic;
            in27 : in std_logic;
            in28 : in std_logic;
            in29 : in std_logic;
            in30 : in std_logic;
            in31 : in std_logic;
            in32 : in std_logic;
            in33 : in std_logic;
            in34 : in std_logic;
            in35 : in std_logic;
            in36 : in std_logic;
            in37 : in std_logic;
            in38 : in std_logic;
            in39 : in std_logic;
            in40 : in std_logic;
            in41 : in std_logic;
            in42 : in std_logic;
            in43 : in std_logic;
            in44 : in std_logic;
            in45 : in std_logic;
            in46 : in std_logic;
            in47 : in std_logic;
            in48 : in std_logic;
            in49 : in std_logic;
            in50 : in std_logic;
            in51 : in std_logic;
            in52 : in std_logic;
            in53 : in std_logic;
            in54 : in std_logic;
            in55 : in std_logic;
            in56 : in std_logic;
            in57 : in std_logic;
            in58 : in std_logic;
            in59 : in std_logic;
            in60 : in std_logic;
            in61 : in std_logic;
            in62 : in std_logic;
            in63 : in std_logic;
            in64 : in std_logic;
            in65 : in std_logic;
            in66 : in std_logic;
            in67 : in std_logic;
            in68 : in std_logic;
            in69 : in std_logic;
            in70 : in std_logic;
            in71 : in std_logic;
            in72 : in std_logic;
            in73 : in std_logic;
            in74 : in std_logic;
            in75 : in std_logic;
            in76 : in std_logic;
            in77 : in std_logic;
            in78 : in std_logic;
            in79 : in std_logic;
            in80 : in std_logic;
            in81 : in std_logic;
            in82 : in std_logic;
            in83 : in std_logic;
            in84 : in std_logic;
            in85 : in std_logic;
            in86 : in std_logic;
            in87 : in std_logic;
            in88 : in std_logic;
            in89 : in std_logic;
            in90 : in std_logic;
            in91 : in std_logic;
            in92 : in std_logic;
            in93 : in std_logic;
            in94 : in std_logic;
            in95 : in std_logic;
            in96 : in std_logic;
            in97 : in std_logic;
            in98 : in std_logic;
            in99 : in std_logic;
            in100 : in std_logic;
            in101 : in std_logic;
            in102 : in std_logic;
            in103 : in std_logic;
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
            in228 : in std_logic;
            in229 : in std_logic;
            in230 : in std_logic;
            in231 : in std_logic;
            in232 : in std_logic;
            in233 : in std_logic;
            in234 : in std_logic;
            in235 : in std_logic;
            in236 : in std_logic;
            in237 : in std_logic;
            in238 : in std_logic;
            in239 : in std_logic;
            in240 : in std_logic;
            in241 : in std_logic;
            in242 : in std_logic;
            in243 : in std_logic;
            in244 : in std_logic;
            in245 : in std_logic;
            in246 : in std_logic;
            in247 : in std_logic;
            in248 : in std_logic;
            in249 : in std_logic;
            in250 : in std_logic;
            in251 : in std_logic;
            in252 : in std_logic;
            in253 : in std_logic;
            in254 : in std_logic;
            in255 : in std_logic;
            mux_out : out std_logic
        );
    end component;

    component mux_16to1 is
        port (
            mux_sel : in std_logic_vector(3 downto 0);
            in0 : in std_logic;
            in1 : in std_logic;
            in2 : in std_logic;
            in3 : in std_logic;
            in4 : in std_logic;
            in5 : in std_logic;
            in6 : in std_logic;
            in7 : in std_logic;
            in8 : in std_logic;
            in9 : in std_logic;
            in10 : in std_logic;
            in11 : in std_logic;
            in12 : in std_logic;
            in13 : in std_logic;
            in14 : in std_logic;
            in15 : in std_logic;
            mux_out : out std_logic
        );
    end component;


    signal exc_spikes_sampled : std_logic_vector(n_exc_inputs-1 downto 0);
    signal inh_spikes_sampled : std_logic_vector(n_inh_inputs-1 downto 0);
    signal exc_cnt_sig : std_logic_vector(exc_cnt_bitwidth-1 downto 0);
    signal inh_cnt_sig : std_logic_vector(inh_cnt_bitwidth-1 downto 0);

begin

    exc_cnt <= exc_cnt_sig;
    inh_cnt <= inh_cnt_sig;


    exc_or : generic_or
        generic map(
            N => n_exc_inputs
        )
        port map(
            or_in => exc_spikes,
            or_out => exc_yes
        );

    inh_or : generic_or
        generic map(
            N => n_inh_inputs
        )
        port map(
            or_in => inh_spikes,
            or_out => inh_yes
        );

    exc_reg : reg_sync_rst
        generic map(
            N => n_exc_inputs
        )
        port map(
            clk => clk,
            en => exc_sample,
            rst_n => exc_rst_n,
            reg_in => exc_spikes,
            reg_out => exc_spikes_sampled
        );

    inh_reg : reg_sync_rst
        generic map(
            N => n_inh_inputs
        )
        port map(
            clk => clk,
            en => inh_sample,
            rst_n => inh_rst_n,
            reg_in => inh_spikes,
            reg_out => inh_spikes_sampled
        );

    exc_mux : mux_256to1
        port map(
            mux_sel => exc_cnt_sig,
            in0 => exc_spikes_sampled(0),
            in1 => exc_spikes_sampled(1),
            in2 => exc_spikes_sampled(2),
            in3 => exc_spikes_sampled(3),
            in4 => exc_spikes_sampled(4),
            in5 => exc_spikes_sampled(5),
            in6 => exc_spikes_sampled(6),
            in7 => exc_spikes_sampled(7),
            in8 => exc_spikes_sampled(8),
            in9 => exc_spikes_sampled(9),
            in10 => exc_spikes_sampled(10),
            in11 => exc_spikes_sampled(11),
            in12 => exc_spikes_sampled(12),
            in13 => exc_spikes_sampled(13),
            in14 => exc_spikes_sampled(14),
            in15 => exc_spikes_sampled(15),
            in16 => exc_spikes_sampled(16),
            in17 => exc_spikes_sampled(17),
            in18 => exc_spikes_sampled(18),
            in19 => exc_spikes_sampled(19),
            in20 => exc_spikes_sampled(20),
            in21 => exc_spikes_sampled(21),
            in22 => exc_spikes_sampled(22),
            in23 => exc_spikes_sampled(23),
            in24 => exc_spikes_sampled(24),
            in25 => exc_spikes_sampled(25),
            in26 => exc_spikes_sampled(26),
            in27 => exc_spikes_sampled(27),
            in28 => exc_spikes_sampled(28),
            in29 => exc_spikes_sampled(29),
            in30 => exc_spikes_sampled(30),
            in31 => exc_spikes_sampled(31),
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
            in251 => exc_spikes_sampled(251),
            in252 => exc_spikes_sampled(252),
            in253 => exc_spikes_sampled(253),
            in254 => exc_spikes_sampled(254),
            in255 => exc_spikes_sampled(255),
            mux_out => exc_spike
        );

    inh_mux : mux_16to1
        port map(
            mux_sel => inh_cnt_sig,
            in0 => inh_spikes_sampled(0),
            in1 => inh_spikes_sampled(1),
            in2 => inh_spikes_sampled(2),
            in3 => inh_spikes_sampled(3),
            in4 => inh_spikes_sampled(4),
            in5 => inh_spikes_sampled(5),
            in6 => inh_spikes_sampled(6),
            in7 => inh_spikes_sampled(7),
            in8 => inh_spikes_sampled(8),
            in9 => inh_spikes_sampled(9),
            in10 => '0',
            in11 => '0',
            in12 => '0',
            in13 => '0',
            in14 => '0',
            in15 => '0',
            mux_out => inh_spike
        );

    exc_counter : cnt
        generic map(
            N => exc_cnt_bitwidth,
            rst_value => 255
        )
        port map(
            clk => clk,
            cnt_en => exc_cnt_en,
            cnt_rst_n => exc_cnt_rst_n,
            cnt_out => exc_cnt_sig
        );

    inh_counter : cnt
        generic map(
            N => inh_cnt_bitwidth,
            rst_value => 15
        )
        port map(
            clk => clk,
            cnt_en => inh_cnt_en,
            cnt_rst_n => inh_cnt_rst_n,
            cnt_out => inh_cnt_sig
        );

    exc_cmp : cmp_eq
        generic map(
            N => exc_cnt_bitwidth
        )
        port map(
            in0 => exc_cnt_sig,
            in1 => std_logic_vector(to_unsigned(n_exc_inputs-2, exc_cnt_bitwidth)),
            cmp_out => exc_stop
        );

    inh_cmp : cmp_eq
        generic map(
            N => inh_cnt_bitwidth
        )
        port map(
            in0 => inh_cnt_sig,
            in1 => std_logic_vector(to_unsigned(n_inh_inputs-2, inh_cnt_bitwidth)),
            cmp_out => inh_stop
        );


end architecture behavior;
