creagic11/SNN_BTP/(commit log)

2026-10-24 T0.5: dataset download script; T0.6: integer-faithful trainer and encoder
    Claude-Session: https://claude.ai/code/session_01Hw8jx78xk3Pg1PE7NFKsJe
2026-10-24 T3.1 prep: board top (autorun), Nexys A7-100T XDC, Vivado non-project build script
    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
2026-10-26 P1.5: clamped low-rank hibernation in golden (+test), post-hoc ceiling study
    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
2026-10-26 Trainer: lr1 (clamped rounded-mean) hibernation, env loss for recurrent rows; gated rec sweep script
    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
2026-10-26 Trainer: per-batch gradient logging and spike checkpoint (--log_grad); het run log
    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
2026-10-26 Round-1 ablation results (theta/4 best, het breaks training, dropout neutral+); revert surrogate default; SHD channel pooling; round-2 ablation script
    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
2026-10-26 Delay-SNN probe script
    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
2026-10-26 Delay probes (delays 2x no-delay; BN helps); training-time BN option
    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
2026-10-26 Bias current (golden + trainer), BN export, per-layer theta; Theorem 1' test with bias
    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
2026-10-26 Delay gated sweep: separate lr for bias current (headroom), lr 0.01; headroom diagnosis
    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
2026-10-27 Timing fix 2: two-stage finalize (register saturated U + awake, then spike/reset), +1 cycle/block; cycle model updated; regression 40/40, N-MNIST mf/drop/base bit-exact
    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
2026-10-27 Timing fix 3: balanced two-stage max tree for R (8->2 registered, 2->1 into R); bit-exact, cycles unchanged; regression 40/40, N-MNIST mf/drop PASS
    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
2026-10-27 Docs sync 27 Oct: progress (current state, decisions log, Paper A/B tracks, statuses), study (corrections + SOTA comparison section), tier-1 plan update, FPGA/formal READMEs, yosys superseded note, p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
2026-10-27 A3 prep: fix autorun (back-to-back inferences), SAIF testbench (per-sample memory swap, cycle-checked), make_saif_hex.py (100 samples, 3 weight sets), run_saif.tcl (rebuild + xsim SAIF + report_power)
    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
2026-10-27 progress: A3 SAIF flow ready and delivered
    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
2026-10-27 A3: run_saif.tcl - avoid '=' on xelab/xsim command lines (Windows .bat splits at '='): per-case testbench with parameters and paths baked in; tested with tclsh + iverilog
    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
2026-10-27 progress: SAIF attempt 1 invalid (2-3% nets matched); diagnosis and proper flow
    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
2026-10-27 A3 proper flow: on-chip multi-sample event store (NSMP, smp port, sample stepping in top), EAW zero-extension fix for ts entries, build.tcl NSMP/NEV, tb_net + run_power.tcl (gate-level SAIF), make_po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
2026-10-27 progress: A3 gate-level flow delivered
    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
2026-10-28 A3: fix read_saif parse failure on (null)-named netlist wires; annotate_power2 re-annotation without re-simulation
    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
2026-10-28 A3: SAIF power with 100% net match archived (results/power_saif), honest caveats
    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
2026-10-28 A3b: hush_layer v5 (writable RAMs + UART load port, per-column weight enables, ts2 BRAM pairs, ram_decomp power, named scopes); run_v5 flow
    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
2026-10-28 A3b: fix observability (all lanes folded into LEDs; earlier builds pruned BASE lanes 6-25); out_v5b
    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
2026-10-28 A3 done: v5 SAIF power/area results (results/power_saif_v5)
    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
2026-10-28 Report v2 numbers: README, fpga/README (v5 flow), novelty_check, study, superseded banners, whole-network table
    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
2026-10-28 A3: archive full Vivado reports of run out_v5c (timing, util, ram_util, power, sim logs)
    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
2026-10-28 power_saif_v5: point README to archived reports
    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
2026-11-03 A4.3: full Spiker+ design in GHDL, model delay corrected (0), 20-sample run started
    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
2026-11-03 A4.4: Spiker+ FPGA harness (GHDL bit-exact), Vivado flow and gate-level tb
    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
2026-11-03 A4.3 done: Spiker+ GHDL 20 samples bit-exact, 81,422 cycles mean
    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
2026-11-03 A9.1: N-MNIST stream statistics at sensor timing (10k samples) and per-bin work
    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
2026-11-10 A9.2: full network on chip (hush_net: hidden layer -> spike FIFO/drain -> output layer -> integer class), cycle model; hush_layer stream ports (A9.3 groundwork)
    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
2026-11-10 A9.3: stream mode - sensor front-end (pooling, per-window dedup, input FIFO, ring event memory, end-of-window markers), hidden layer launches each window when it closes; bit-exact at 1000x/2000x repl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
2026-11-10 A9.2: whole-network latency on chip (3 seeds), 50-sample bit-exact checks x4; L1 prep: top_net (power + stream builds), memory images; restart protocol fix
    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
2026-11-10 run_l1.bat CRLF; final 50-sample network checks (4 x 50/50 cycle-exact) and 80/80 regression
    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
2026-11-10 A9.7: accuracy vs elapsed sensor time (10k samples)
    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
2026-11-10 A9.4: BASE at true sensor timing, 4 recordings
    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
2026-11-10 A9.4: HUSH gentle at true sensor timing, 4 recordings; summary
    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
2026-11-10 A9.4 done: sensor-timing and replay-sweep tables
    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
2026-11-10 L1 results: whole-network power and energy (BASE, 3 HUSH points), Spiker+ same-chip power, stream builds
    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
2026-11-10 Draft: L1 energy, power and Spiker+ numbers filled in; energy vs SOTA
    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
2026-11-10 Draft revised after internal review (overclaims, baseline/power basis, heuristic caveats, Spiker+ fairness, real-time scope, SOTA wording, loss definitions); L2 extended with SAIF power of the 22-epo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
2026-11-10 L2 results: 22-epoch BASE power (= L1), Spiker+ meets 100 MHz with high effort, stream builds with marker fix; draft updated
    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
2026-11-11 Drift measurement: 0 spikes suppressed vs same-state ungated update (3 points x 1,000 samples); whole-recording divergence quantified
    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
2026-11-11 Resource accounting of the four builds (power vs stream), per module
    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
2026-11-11 Heuristic comparison (reads-matched, 1,000 samples, predictor reads charged): HUSH 94.8 %/0, Early-style 92.4 %/485, SITRA-inspired 68.1 %/117k
    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
2026-11-11 Heuristic comparison with charged reads in the paper (Table) and results/heuristic_gates.md
    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
2026-11-11 Docs: primer rewritten for the current state, study checklist Phase 6, README, outline, FPGA flow notes
    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
